frahncky/IoTMotor/THIRD_PARTY_NOTICES.md

# Third-party notices

## Motor sound

The base motor recording used by IoTMotor was obtained from **Pixabay** through
the following sound-effects search page:

https://pixabay.com/pt/sound-effects/search/electric-motor/

Project source file:

```text
dashboard-cloudflare/motor-ligado.mp3
```

Derived application assets:

```text
assets/audio/motor-partida.wav
assets/audio/motor-laco.wav
assets/audio/motor-parada.wav
```

The exact Pixabay item URL, title and contributor were not recorded at the time
of download. If recovered, add them to this file and to
[`docs/audio.md`](docs/audio.md).

License information should be checked against the current Pixabay Content
License:

https://pixabay.com/service/license-summary/

See [`docs/audio.md`](docs/audio.md) for the complete provenance and processing
notes.
