frahncky/IoTMotor/esp32/iotmotor_esp32/iotmotor_esp32_comandos/LEIA-ME-BANCADA.md

# Quadro de comando (ESP32-01)

Sketch `iotmotor_esp32_comandos.ino` para **ESP32 DevKit V1**, ID MQTT `esp32-01`.
Mede com o PZEM-004T, mostra no LCD 20×4 e aciona os contatores CNT 1 a CNT 4 por MQTT.

- Ligações e pinos: [docs/hardware.md](../../../docs/hardware.md#quadro-de-comando-esp32-01)
- Gravar e atualizar: [docs/firmware.md](../../../docs/firmware.md)
- Comandos e telemetria: [docs/mqtt.md](../../../docs/mqtt.md#comandos-do-quadro-de-comando)
- Segurança do ensaio e modo instrumentação: [docs/guia-de-uso.md](../../../docs/guia-de-uso.md#segurança-do-ensaio)
