frahncky/IoTMotor/dashboard-cloudflare/hardware.html

ESP32-01 · PZEM-004T · LCD 20×4

# Pinos e visor LCD

← Voltar ao dashboard

Estado lógico informado pelo firmware; não confirma a posição física dos contatores.

## Contatores

Aguardando dados do ESP32.

CNT 1GPIO19

Sem sinal

CNT 2GPIO18

Sem sinal

CNT 3GPIO23

Sem sinal

CNT 4GPIO27

Sem sinal

PZEM: TX → GPIO16 (RX2), RX → GPIO17 (TX2). LCD I²C: SDA → GPIO21, SCL → GPIO22.

## LCD 20 × 4

Aguardando dados do ESP32.

IoTMotor Modulo 1   
Aguardando dados...

Nenhuma telemetria recente.

## Conexão MQTT

Broker WSS

Prefixo

Dispositivo de comandos

Conectar

Desconectado

Estado do acionamento—Modo de partida—PZEM—Status MQTT recebido—Mensagens novas0

Conecte para acompanhar a telemetria.
