frahncky/IoTMotor/docs/images/celular.png

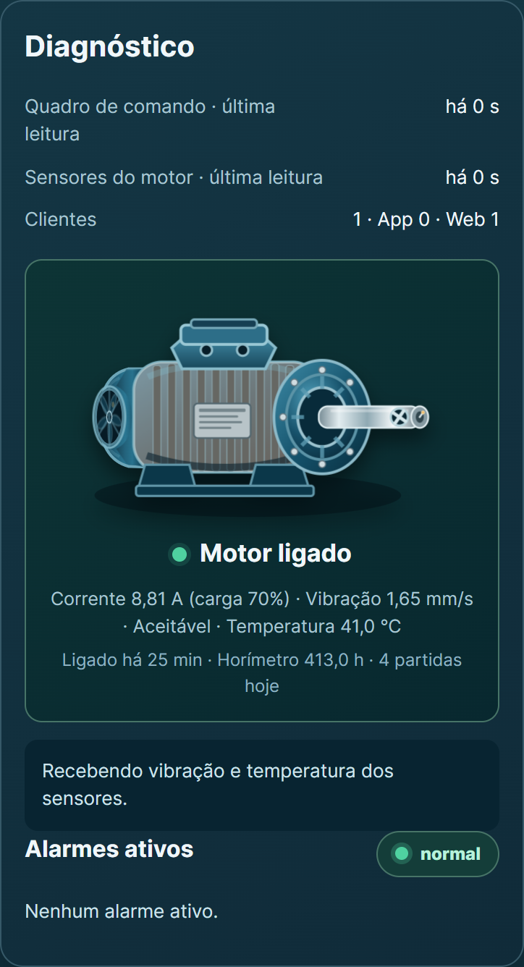
docs/images/celular.png
