frahncky/IoTMotor/docs/images/social-preview.png

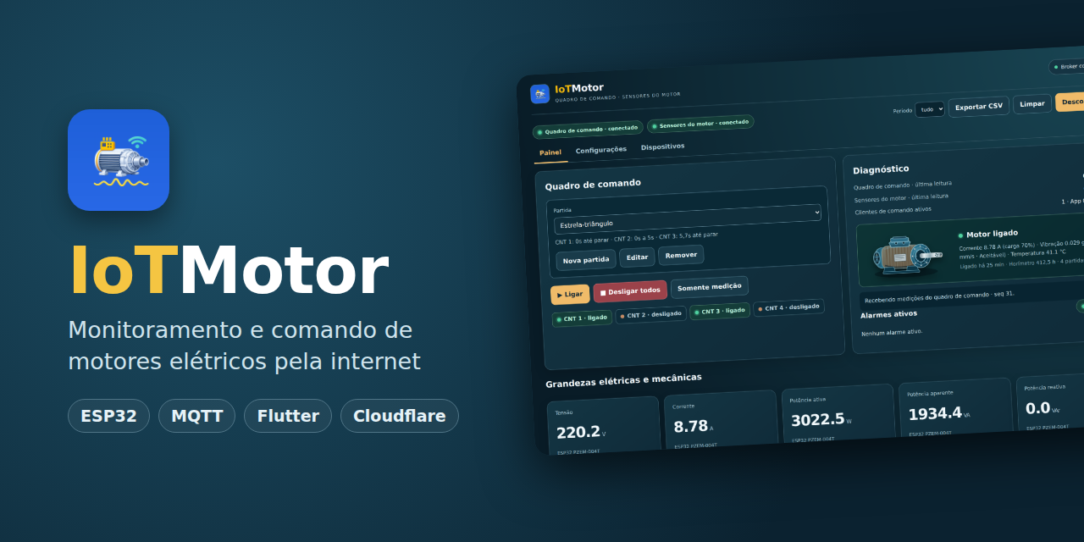
docs/images/social-preview.png
