frahncky/IoTMotor/(list of files, drawings)

Other design files:
hardware/PCBComandos.pdsprj
hardware/PCBSensor.pdsprj
