frahncky/IoTMotor/esp32/iotmotor_esp32/iotmotor_esp32_s3_sensores/iotmotor_esp32_s3_sensores.ino

/* IoTMotor â€” ESP32-S3 (esp32-02): sensores e alarme local, SEM reles.
 * Este sketch pressupoe MPU6050 (SDA GPIO5, SCL GPIO9) e DS18B20
 * (DQ GPIO4, resistor pull-up 4k7 a 3V3), como no projeto de dois modulos.
 * Confirme os pinos da SUA placa S3 antes de gravar. Sensores reais por padrao:
 * campos invalidos sao omitidos; nao inventamos temperatura ou vibracao.
 * Vibracao em velocidade RMS (mm/s), o padrao de maquinas eletricas
 * (ISO 10816-3 / 20816-3): 1000 amostras/s integradas nos 3 eixos (vibracao.h).
 * Bibliotecas: PubSubClient, ArduinoJson 6.x, OneWire, DallasTemperature.
 * Comandos de alarme, Wi-Fi e OTA; nenhum comando de motor.
 */
#include <WiFi.h>
#include <PubSubClient.h>
#include <ArduinoJson.h>
#include <Wire.h>
#include <OneWire.h>
#include <DallasTemperature.h>
#include <math.h>
#include <Preferences.h>
#include <freertos/FreeRTOS.h>
#include <freertos/task.h>
#include <freertos/semphr.h>
#include "mqtt_websocket_client.h"
#define OTA_ARQUIVO "esp32-02.bin"
#define PORTAL_NOME "IoTMotor-esp32-02"
constexpr uint16_t PORTAL_SEGUNDOS = 180;
#include "ota_update.h"
#include "watchdog.h"
#include "wifi_portal.h"
#include "alarm_list.h"
#include "comando_seguro.h"
#include "relogio.h"
#include "historico.h"
#include "vibracao.h"
#include "vibracao_json.h"

// Rede local: crie wifi_local.h na pasta do sketch (fora do Git) a partir de
// wifi_local.exemplo.h para usar outra rede sem publicar a senha no GitHub.
#if __has_include("wifi_local.h")
#include "wifi_local.h"
#endif
#ifndef WIFI_SSID_LOCAL
#define WIFI_SSID_LOCAL "IFMA_IOT"
#define WIFI_PASSWORD_LOCAL ""  // Wi-Fi aberto
#endif
// Redes de wifi_local.h: so semeiam a lista gravada na placa no primeiro boot.
// Depois, a lista e a ordem sao definidas pela aba "Wi-Fi" do painel.
const char* const REDES_INICIAIS[]={
  WIFI_SSID_LOCAL,
#ifdef WIFI_SSID_2
  WIFI_SSID_2,
#endif
#ifdef WIFI_SSID_3
  WIFI_SSID_3,
#endif
#ifdef WIFI_SSID_4
  WIFI_SSID_4,
#endif
};
const char* const SENHAS_INICIAIS[]={
  WIFI_PASSWORD_LOCAL,
#ifdef WIFI_SSID_2
  WIFI_PASSWORD_2,
#endif
#ifdef WIFI_SSID_3
  WIFI_PASSWORD_3,
#endif
#ifdef WIFI_SSID_4
  WIFI_PASSWORD_4,
#endif
};
static const char* MQTT_HOST = "iotmotor.pages.dev";
static const uint16_t MQTT_PORT = 443;  // MQTT sobre WebSocket: a IFMA_IOT bloqueia 1883/8883
static const char* TOPIC_PREFIX = "iotmotor";
static const char* DEVICE_ID = "esp32-02";

static const uint8_t SDA_PIN = 5;
static const uint8_t SCL_PIN = 9;
static const uint8_t DS18B20_PIN = 4;
// Sinalizacao local da placa (mesma pinagem do modulo 2 original).
static const uint8_t BUZZER_PIN = 42;      // Passivo: acionado com tone().
static const uint8_t LED_AZUL_PIN = 16;
static const uint8_t LED_VERDE_PIN = 17;
static const uint8_t LED_VERM_PIN = 18;
static const bool RGB_ANODO_COMUM = false;  // Catodo comum: nivel alto acende.
static const uint32_t BEEP_MS = 400UL;      // Intervalo do alarme intermitente.
static const uint16_t BEEP_HZ_PADRAO = 2000;
static const uint16_t BEEP_HZ_MIN = 500;
static const uint16_t BEEP_HZ_MAX = 5000;
// Limites padrao do alarme; ajustaveis pelo painel e gravados na placa.
// Vibracao em mm/s RMS: 4,5 e o limite de zona D das maquinas pequenas (ISO 10816).
static const float VIBRACAO_LIMITE_PADRAO = 4.5f;
static const float TEMPERATURA_LIMITE_PADRAO = 60.0f;
static const uint8_t MPU_ADDR = 0x68;
static const uint32_t WIFI_RETRY_MS = 6000UL;
static const uint32_t WIFI_RADIO_RESET_MS = 30000UL;
static const uint32_t MQTT_RETRY_MS = 4000UL;
static const uint32_t DIAGNOSTICO_PUBLICAR_MS = 30000UL;
static uint32_t publishMs = 1000UL;
static const uint32_t TEMP_REQUEST_MS = 2000UL;
static const uint32_t TEMP_WAIT_MS = 800UL; // DS18B20 12-bit: ate 750 ms

MqttWebSocketClient net;
PubSubClient mqtt(net);
// Criados apos a procura do sensor: o GPIO4 e o esperado, mas cada placa S3 varia.
OneWire* oneWire=nullptr;
DallasTemperature* ds18b20=nullptr;
uint8_t ds18b20Pin=0;
// Pinos livres candidatos (fora de I2C 5/9, USB 19/20, UART 43/44, strapping
// e dos pinos do LED/buzzer 16/17/18/42).
static const uint8_t DS18B20_CANDIDATOS[]={DS18B20_PIN,1,2,6,7,8,10,11,12,13,14,15,21,38,39,40,41,47,48};
char telemetryTopic[96], statusTopic[96], capabilitiesTopic[96], commandTopic[96], ackTopic[96], wifiTopic[96];
char alarmsTopic[96], quadroTelemetryTopic[96], authTopic[96], alarmLogTopic[96], historyTopic[96], acquisitionTopic[96];
char quadroCommandTopic[96];
uint32_t lastWifiAttempt=0,lastMqttAttempt=0,lastPublish=0,lastHistorico=0,lastDiagnosticsPublish=0;
uint32_t wifiCaiuEm=0;
uint32_t lastTempRequest=0,tempRequestedAt=0,sequence=0,lastMpuRetry=0;
static const uint32_t MPU_RETRY_MS = 5000UL;
// Pedido de reinicio remoto (0 = nenhum); o loop() espera a resposta sair.
uint32_t reiniciarEm=0;
// Sem DS18B20 no boot (mau contato, fio solto), procura de novo sem reiniciar.
static const uint32_t DS18B20_RETRY_MS = 30000UL;
uint32_t lastDs18b20Retry=0;
float temperatureC=NAN;
bool mpuReady=false,tempPending=false,tempReady=false;
// Alarme local: LED RGB e buzzer.
bool alarmeHabilitado=true,estadoCritico=false,buzzerLigado=false;
bool sonsDeEventos=true;  // Bipes curtos de evento, fora da emergencia.
uint16_t buzzerHz=BEEP_HZ_PADRAO;  // Frequencia ajustavel pelo painel e gravada na placa.
uint32_t ultimoBeep=0,inicioDoTeste=0;
bool testeAtivo=false;
bool testeLedAtivo=false;
uint32_t inicioTesteLed=0;
// Ultima janela de 1 s (vibracao.h): velocidade RMS em mm/s.
float mmsAtual=0.0f;
char eixoAtual='x';
bool mmsValida=false;
uint32_t mmsEm=0;  // Quando saiu a ultima velocidade valida.
// Uma janela falha (FIFO cheia durante a procura do DS18B20, por exemplo) nao
// derruba a leitura: sem isso um alarme disparado fecharia e reabriria.
static const uint32_t MMS_VALIDADE_MS = 3000UL;
uint32_t amostrasAtuais=0;
// Estado do motor vem da telemetria do quadro de comando (esp32-01).
bool motorLigado=false;
bool motorGirandoQuadro=false;  // Horimetro do quadro: girando (inclui instrumentacao).
bool saidasDoQuadro=false;      // Algum contator do quadro ligado (ou partida em andamento).
// Desarme: o ultimo Desligar mandado ao quadro por um alarme com desarme.
static const uint32_t DESARME_REPETIR_MS=3000UL;
uint32_t ultimoDesarme=0,sequenciaDesarme=0;
uint32_t ultimaTelemetriaQuadro=0;
static const uint32_t QUADRO_STALE_MS=6000UL;
// Sensores e sinalizacao continuam durante reconexao Wi-Fi, portal e MQTT.
SemaphoreHandle_t sensoresMutex=nullptr;
void aplicarLed(bool azul,bool verde,bool vermelho) {
  digitalWrite(LED_AZUL_PIN, azul==!RGB_ANODO_COMUM?HIGH:LOW);
  digitalWrite(LED_VERDE_PIN, verde==!RGB_ANODO_COMUM?HIGH:LOW);
  digitalWrite(LED_VERM_PIN, vermelho==!RGB_ANODO_COMUM?HIGH:LOW);
}

// Interruptor geral e bipes de evento; os limites ficam na lista de alarmes.
void carregarConfigDoAlarme() {
  Preferences memoria;
  if(!memoria.begin("iot-alarme",true))return;
  alarmeHabilitado=memoria.getBool("ligado",true);
  sonsDeEventos=memoria.getBool("sons",true);
  buzzerHz=constrain((int)memoria.getUShort("buzzer_hz",BEEP_HZ_PADRAO),BEEP_HZ_MIN,BEEP_HZ_MAX);
  memoria.end();
}

bool salvarConfigDoAlarme(bool ligado,bool sons,uint16_t frequencia) {
  Preferences memoria;
  if(!memoria.begin("iot-alarme",false))return false;
  memoria.putBool("ligado",ligado);
  memoria.putBool("sons",sons);
  memoria.putUShort("buzzer_hz",frequencia);
  memoria.end();
  xSemaphoreTake(sensoresMutex,portMAX_DELAY);
  alarmeHabilitado=ligado;sonsDeEventos=sons;buzzerHz=frequencia;
  xSemaphoreGive(sensoresMutex);
  return true;
}

// ---- Bipes curtos fora da emergencia ----
// Avisos de conexao e de comando recebido, e o bipe pedido pelo painel. Sao
// tocados sem travar o laco e nunca atrapalham o alarme, que tem prioridade.
uint8_t beepsRestantes=0;
uint16_t beepFrequencia=BEEP_HZ_PADRAO;
uint32_t beepDuracao=80,beepProximo=0;
bool beepTocando=false;

void pedirBeep(uint8_t vezes,uint16_t frequencia,uint32_t duracaoMs) {
  if(!vezes)return;
  beepsRestantes=vezes;
  beepFrequencia=frequencia;
  beepDuracao=duracaoMs;
  beepProximo=millis();
  beepTocando=false;
}

// ---- Procura do buzzer ----
// Percorre os pinos livres tocando de dois jeitos: tone (buzzer passivo) e
// nivel alto (buzzer ativo). Cada passo e anunciado em command_ack, entao da
// para casar o som ouvido com o pino. Anda no laco principal: chamar
// mqtt.loop() de dentro do tratador de comandos corrompe as mensagens.
static const uint8_t BUZZER_CANDIDATOS[]={42,41,40,39,38,47,48,21,14,13,12,11,10,8,7,6,2,1};
bool probeAtivo=false,probeTocando=false;
uint8_t probeIndice=0,probeModo=0;
uint32_t probePasso=700,probeProximo=0;
String probeSeq;

void beepDeEvento(uint8_t vezes) {
  if(sonsDeEventos)pedirBeep(vezes,buzzerHz,70);
}

// Retorna true enquanto estiver tocando um bipe (o alarme nao mexe no buzzer).
bool atualizarBeeps(uint32_t now) {
  if(!beepsRestantes&&!beepTocando)return false;
  if((int32_t)(now-beepProximo)<0)return true;
  if(beepTocando) {          // Fim do som: silencio do mesmo tamanho.
    noTone(BUZZER_PIN);
    beepTocando=false;
    beepProximo=now+beepDuracao;
    if(!beepsRestantes)return false;
    return true;
  }
  if(!beepsRestantes)return false;
  --beepsRestantes;
  tone(BUZZER_PIN,beepFrequencia);
  beepTocando=true;
  beepProximo=now+beepDuracao;
  return true;
}

// Lista de alarmes retida, para o painel e o app abrirem ja preenchidos.
void publishAlarms() {
  if(!mqtt.connected())return;
  DynamicJsonDocument doc(alarmes::TAMANHO_DOC_ALARMES);
  doc["device_id"]=DEVICE_ID;
  xSemaphoreTake(sensoresMutex,portMAX_DELAY);
  doc["enabled"]=alarmeHabilitado;
  doc["sounds"]=sonsDeEventos;
  doc["buzzer_hz"]=buzzerHz;
  alarmes::descrever(doc);
  xSemaphoreGive(sensoresMutex);
  String texto;
  serializeJson(doc,texto);
  if(texto.length())
    mqtt.publish(alarmsTopic,(const uint8_t*)texto.c_str(),(unsigned int)texto.length(),true);
}

// Ultimos disparos, retidos: o painel abre ja mostrando o que aconteceu.
void publishAlarmLog() {
  if(!mqtt.connected())return;
  // 10 eventos com "trip" passam de 1,5 KB: sobra para nao cortar o fim.
  DynamicJsonDocument doc(3072);
  doc["device_id"]=DEVICE_ID;
  xSemaphoreTake(sensoresMutex,portMAX_DELAY);
  alarmes::descreverEventos(doc);
  alarmes::eventosMudaram=false;
  xSemaphoreGive(sensoresMutex);
  if(doc.overflowed()) {
    Serial.println("[S3/alarmes] registro nao coube no documento; nao publicado");
    return;
  }
  String texto;
  serializeJson(doc,texto);
  if(texto.length())
    mqtt.publish(alarmLogTopic,(const uint8_t*)texto.c_str(),(unsigned int)texto.length(),true);
}

// Historico por hora (historico.h): um topico retido por dia, <prefixo>/<placa>/history/<0..6>.
void publishHistory(uint8_t slot) {
  if(!mqtt.connected())return;
  DynamicJsonDocument doc(4608);
  doc["device_id"]=DEVICE_ID;
  historico::descrever(slot,doc);
  String texto;
  serializeJson(doc,texto);
  char topico[112];
  snprintf(topico,sizeof(topico),"%s/%u",historyTopic,slot);
  if(texto.length()&&!mqtt.publish(topico,(const uint8_t*)texto.c_str(),(unsigned int)texto.length(),true))
    Serial.printf("[S3/historico] falha publicando dia %u (%u bytes)\n",slot,(unsigned int)texto.length());
}

// Uma amostra por segundo para o historico, com as mesmas leituras da telemetria.
void amostrarHistorico() {
  xSemaphoreTake(sensoresMutex,portMAX_DELAY);
  const bool quadroFresco=ultimaTelemetriaQuadro&&(uint32_t)(millis()-ultimaTelemetriaQuadro)<QUADRO_STALE_MS;
  const bool ligado=quadroFresco&&motorGirandoQuadro;
  auto doQuadro=[&](const char* campo){
    return quadroFresco&&alarmes::medidasDoQuadro[campo].is<float>()?alarmes::medidasDoQuadro[campo].as<float>():NAN;
  };
  const float corrente=doQuadro("current"),tensao=doQuadro("voltage");
  const float temperatura=tempReady&&isfinite(temperatureC)?temperatureC:NAN;
  const float vibracao=mpuReady&&mmsValida?mmsAtual:NAN;
  xSemaphoreGive(sensoresMutex);
  historico::amostrar(relogio::agoraUtc(),ligado,corrente,tensao,temperatura,vibracao);
  if(historico::diaParaPublicar>=0){
    publishHistory((uint8_t)historico::diaParaPublicar);
    historico::diaParaPublicar=-1;
  }
}

// Desafio da vez, retido: o painel precisa dele para cifrar um comando.
void publishAuth() {
  if(!mqtt.connected())return;
  StaticJsonDocument<192> doc;
  doc["v"]=1;
  doc["device_id"]=DEVICE_ID;
  comandoseguro::descrever(doc);
  char payload[192];size_t n=serializeJson(doc,payload,sizeof(payload));
  if(n)mqtt.publish(authTopic,(const uint8_t*)payload,(unsigned int)n,true);
}

void publishAck(const char* seq,const char* acao,bool aceito,const char* motivo);

// Avanca a procura do buzzer; true enquanto ela estiver em andamento.
bool atualizarProcuraDoBuzzer(uint32_t now) {
  if(!probeAtivo)return false;
  if((int32_t)(now-probeProximo)<0)return true;
  const uint8_t pino=BUZZER_CANDIDATOS[probeIndice];
  if(probeTocando) {            // Fim do passo: solta o pino e faz uma pausa.
    if(probeModo)digitalWrite(pino,LOW);
    else noTone(pino);
    pinMode(pino,INPUT);
    probeTocando=false;
    probeProximo=now+250;
    if(++probeModo>1) {
      probeModo=0;
      if(++probeIndice>=sizeof(BUZZER_CANDIDATOS)) {
        probeAtivo=false;
        pinMode(BUZZER_PIN,OUTPUT);
        publishAck(probeSeq.c_str(),"buzzer_probe",true,"procura encerrada");
        return false;
      }
    }
    return true;
  }
  // Pula os pinos que ja tem dono nesta placa.
  if(pino==LED_AZUL_PIN||pino==LED_VERDE_PIN||pino==LED_VERM_PIN||pino==ds18b20Pin) {
    probeModo=0;
    if(++probeIndice>=sizeof(BUZZER_CANDIDATOS)) {probeAtivo=false;return false;}
    return true;
  }
  char aviso[64];
  snprintf(aviso,sizeof(aviso),"GPIO%u %s",pino,probeModo?"nivel alto (ativo)":"tone (passivo)");
  publishAck(probeSeq.c_str(),"buzzer_probe",true,aviso);
  Serial.printf("[BUZZER] %s\n",aviso);
  if(probeModo){pinMode(pino,OUTPUT);digitalWrite(pino,HIGH);}
  else tone(pino,buzzerHz);
  probeTocando=true;
  probeProximo=now+probePasso;
  return true;
}

void iniciarTesteLed(uint32_t now) {
  testeLedAtivo=true;
  inicioTesteLed=now;
  noTone(BUZZER_PIN);
  buzzerLigado=false;
  beepsRestantes=0;
  beepTocando=false;
}

bool atualizarTesteLed(uint32_t now) {
  if(!testeLedAtivo)return false;
  const uint32_t decorrido=(uint32_t)(now-inicioTesteLed);
  if(decorrido<1000UL) aplicarLed(true,false,false);        // azul
  else if(decorrido<2000UL) aplicarLed(false,true,false);    // verde
  else if(decorrido<3000UL) aplicarLed(false,false,true);    // vermelho
  else {
    testeLedAtivo=false;
    return false;
  }
  return true;
}

// Maquina de estados do LED:
// azul piscando = conectando; azul fixo = conectado/motor desligado;
// verde fixo = motor ligado normal; vermelho piscando = motor ligado anormal;
// vermelho fixo = falha de sensor com motor desligado.
void atualizarSinalizacao(uint32_t now) {
  if(atualizarProcuraDoBuzzer(now))return;  // Procura do buzzer em andamento.
  if(atualizarTesteLed(now))return;

  // Quem decide os alarmes e a lista configurada na placa. Avaliados tambem
  // sem rede: temperatura e vibracao sao medidas aqui mesmo.
  const bool algumDisparou=alarmes::avaliar(now,mpuReady,tempReady,mmsValida?mmsAtual:NAN,
                                            temperatureC,relogio::agoraUtc());
  const bool falhaSensor=!mpuReady || !tempReady;
  estadoCritico=alarmeHabilitado&&(algumDisparou||falhaSensor);

  if(testeAtivo&&(uint32_t)(now-inicioDoTeste)<1500UL)return;
  testeAtivo=false;

  const bool conectado=WiFi.status()==WL_CONNECTED && mqtt.connected();
  // Com rede, se a telemetria do quadro sumir, nao inventa que o motor segue
  // ligado. Sem rede a falha e desta placa, nao do motor: vale o ultimo estado
  // recebido, para o alarme local nao ficar mudo com o motor girando.
  const bool quadroRecente=ultimaTelemetriaQuadro &&
                           (uint32_t)(now-ultimaTelemetriaQuadro)<QUADRO_STALE_MS;
  const bool motorAtivo=conectado?quadroRecente&&motorLigado:motorLigado;

  if(!conectado&&!(motorAtivo&&estadoCritico)) {  // Procurando rede: azul piscando.
    const bool aceso=((now/500UL)&1U)==0U;
    aplicarLed(aceso,false,false);
    if(buzzerLigado){noTone(BUZZER_PIN);buzzerLigado=false;}
    atualizarBeeps(now);  // Termina o bipe em curso; zerar deixaria o tom preso.
    return;
  }

  if(!motorAtivo) {
    if(estadoCritico) aplicarLed(false,false,true);  // falha parada: vermelho fixo
    else aplicarLed(true,false,false);               // conectado/parado: azul fixo
    if(buzzerLigado){noTone(BUZZER_PIN);buzzerLigado=false;}
    // Motor parado nao apita alarme, mas o bipe pedido pelo painel toca.
    atualizarBeeps(now);
    return;
  }

  if(!estadoCritico) {
    aplicarLed(false,true,false);                    // motor ligado normal: verde
    if(buzzerLigado){noTone(BUZZER_PIN);buzzerLigado=false;}
    atualizarBeeps(now);
    return;
  }

  // Motor ligado e anormal: vermelho piscando + buzzer intermitente.
  const bool vermelho=((now/500UL)&1U)==0U;
  aplicarLed(false,false,vermelho);
  beepsRestantes=0;beepTocando=false;
  if((uint32_t)(now-ultimoBeep)>=BEEP_MS) {
    ultimoBeep=now;
    buzzerLigado=!buzzerLigado;
    if(buzzerLigado)tone(BUZZER_PIN,buzzerHz);
    else noTone(BUZZER_PIN);
  }
}

void testarSinalizacao(uint32_t now,uint16_t frequencia) {
  inicioDoTeste=now;testeAtivo=true;
  ultimoBeep=now;
  aplicarLed(true,true,true);
  tone(BUZZER_PIN,frequencia);
  buzzerLigado=true;
}

// Procura um DS18B20 nos pinos candidatos; so aceita ROM lida com CRC valido.
// Retorna true se encontrou. avisarFalha=false evita repetir o aviso a cada nova tentativa.
bool procurarDs18b20(bool avisarFalha) {
  for (uint8_t pino : DS18B20_CANDIDATOS) {
    OneWire barramento(pino);
    DallasTemperature sensor(&barramento);
    sensor.begin();
    DeviceAddress rom;
    // getAddress ja rejeita ROM com CRC invalido (validAddress).
    if (sensor.getDeviceCount() < 1 || !sensor.getAddress(rom,0)) continue;
    ds18b20Pin=pino;
    oneWire=new OneWire(pino);
    ds18b20=new DallasTemperature(oneWire);
    ds18b20->begin();
    ds18b20->setWaitForConversion(false);
    Serial.printf("[S3/DS18B20] encontrado no GPIO%u\n",pino);
    if (pino!=DS18B20_PIN) Serial.printf("[S3/DS18B20] atencao: esperado no GPIO%u\n",DS18B20_PIN);
    return true;
  }
  if (!avisarFalha) return false;
  Serial.printf("[S3/DS18B20] nenhum sensor no GPIO%u nem nos demais pinos livres;"
                " confira DQ, GND, 3V3 e o resistor de 4k7 entre DQ e 3V3;"
                " nova procura a cada %lu s\n",DS18B20_PIN,(unsigned long)(DS18B20_RETRY_MS/1000UL));
  return false;
}

void publishStatus(const char* msg) {
  Serial.printf("[S3/status] %s\n",msg);
  if (mqtt.connected()) mqtt.publish(statusTopic,msg,true);
}

bool mpuWrite(uint8_t reg,uint8_t value) {
  Wire.beginTransmission(MPU_ADDR);
  Wire.write(reg); Wire.write(value);
  return Wire.endTransmission()==0;
}

bool initMpu(bool avisarFalha) {
  // WHO_AM_I (0x75) so confirma presenca: clones MPU6500/9250 respondem 0x70/0x71/0x73
  // e funcionam com os mesmos registradores, entao qualquer resposta e aceita.
  Wire.beginTransmission(MPU_ADDR);
  Wire.write((uint8_t)0x75);
  bool ok=Wire.endTransmission(false)==0 && Wire.requestFrom(MPU_ADDR,(uint8_t)1,(bool)true)==1;
  const uint8_t id=ok?Wire.read():0;
  ok=ok&&mpuWrite(0x6B,0x00);  // wake up
  delay(ok?50:0);              // Acordando: o oscilador precisa estabilizar.
  ok=ok&&vibracao::iniciar(id);
  if(ok) Serial.printf("[S3/MPU6050] iniciado nos GPIO5/9, WHO_AM_I=0x%02X, 1000 amostras/s\n",id);
  else if(avisarFalha) Serial.println("[S3/MPU6050] indisponivel; confira I2C e alimentacao (nova tentativa a cada 5 s)");
  return ok;
}

void sampleMpu() {
  if(!mpuReady)return;
  if(!vibracao::ler()) {
    mpuReady=false;
    Serial.println("[S3/MPU6050] leitura falhou; tentara reiniciar");
  }
}

void pollTemperature(uint32_t now) {
  if(!ds18b20)return;
  if(tempPending && (uint32_t)(now-tempRequestedAt)>=TEMP_WAIT_MS) {
    float reading=ds18b20->getTempCByIndex(0);
    tempReady=isfinite(reading) && reading>-55.0f && reading<125.0f &&
              reading!=85.0f && reading!=DEVICE_DISCONNECTED_C;
    temperatureC=tempReady?reading:NAN;
    static int8_t ultimoEstado=-1;  // Avisa so na mudanca: evita repetir a cada 2 s.
    if(tempReady!=(ultimoEstado==1)||ultimoEstado<0) {
      if(tempReady)Serial.printf("[S3/DS18B20] %.2f C\n",temperatureC);
      else Serial.println("[S3/DS18B20] sensor ausente/leitura invalida");
      ultimoEstado=tempReady?1:0;
    }
    tempPending=false;
  }
  if(!tempPending && (lastTempRequest==0 || (uint32_t)(now-lastTempRequest)>=TEMP_REQUEST_MS)) {
    lastTempRequest=now;
    ds18b20->requestTemperatures(); // setWaitForConversion(false) na deteccao
    tempRequestedAt=now;
    tempPending=true;
  }
}

// Executada independentemente das operacoes de rede potencialmente bloqueantes.
void tarefaSensores(void*) {
  uint32_t ultimaJanela=millis();
  for(;;) {
    const uint32_t now=millis();
    xSemaphoreTake(sensoresMutex,portMAX_DELAY);
    sampleMpu();  // Esvazia a FIFO do MPU (1000 amostras/s).
    if(!mpuReady&&(uint32_t)(now-lastMpuRetry)>=MPU_RETRY_MS) {
      lastMpuRetry=now;
      mpuReady=initMpu(false);
    }
    // Nao varre os pinos enquanto a procura do buzzer pode estar acionando algum deles.
    if(!ds18b20&&!probeAtivo&&(uint32_t)(now-lastDs18b20Retry)>=DS18B20_RETRY_MS) {
      lastDs18b20Retry=now;
      procurarDs18b20(false);
    }
    pollTemperature(now);
    if((uint32_t)(now-ultimaJanela)>=1000UL) {
      ultimaJanela=now;
      vibracao::fecharJanela(mpuReady);
      amostrasAtuais=vibracao::amostras;
      if(vibracao::velocidadeValida) {
        mmsAtual=vibracao::mmS;
        eixoAtual=vibracao::eixo;
        mmsEm=now?now:1;
      }
      mmsValida=mpuReady&&mmsEm&&(uint32_t)(now-mmsEm)<MMS_VALIDADE_MS;
      static uint32_t perdasAvisadas=0;
      if(vibracao::perdas!=perdasAvisadas) {
        Serial.printf("[S3/MPU6050] FIFO cheia %lu vez(es): amostras perdidas\n",(unsigned long)vibracao::perdas);
        perdasAvisadas=vibracao::perdas;
      }
    }
    atualizarSinalizacao(now);
    xSemaphoreGive(sensoresMutex);
    vTaskDelay(pdMS_TO_TICKS(2));
  }
}

void publishCapabilities() {
  StaticJsonDocument<384> doc;
  doc["device_id"]=DEVICE_ID;
  doc["firmware_version"]="s3-sensors-1.23-mqtt-cloudflare";
  doc["demo"]=false;
  doc["accepts_direct_command"]=false;
  doc["accepts_command_request"]=false;
  JsonArray fields=doc.createNestedArray("fields");
  fields.add("vibration_mms");fields.add("temperature");fields.add("vib");
  char payload[384];size_t n=serializeJson(doc,payload,sizeof(payload));
  if(n)mqtt.publish(capabilitiesTopic,(const uint8_t*)payload,(unsigned int)n,true);
}

void publishTelemetry() {
  if(!mqtt.connected())return;
  // Estaticos: com o diagnostico da vibracao, ~5 KB nao cabem na pilha do loop.
  static StaticJsonDocument<3072> doc;
  static char payload[2048];
  doc.clear();
  xSemaphoreTake(sensoresMutex,portMAX_DELAY);
  doc["device_id"]=DEVICE_ID;
  doc["seq"]=++sequence;
  doc["demo"]=false;
  doc["data_source"]="mpu6050_ds18b20";
  doc["mpu_ok"]=mpuReady;
  doc["temperature_ok"]=tempReady;
  doc["sample_count"]=amostrasAtuais;
  doc["secure"]=comandoseguro::ligado;
  // Hora da medicao, em segundos UTC. Ausente enquanto o NTP nao responde.
  if(const uint32_t carimbo=relogio::agoraUtc())doc["ts"]=carimbo;
  doc["alarm_enabled"]=alarmeHabilitado;
  doc["event_sounds"]=sonsDeEventos;
  doc["buzzer_hz"]=buzzerHz;
  doc["alarm_active"]=estadoCritico;
  doc["motor_on"]=motorLigado;
  doc["command_telemetry_fresh"]=ultimaTelemetriaQuadro &&
      (uint32_t)(millis()-ultimaTelemetriaQuadro)<QUADRO_STALE_MS;
  if(mpuReady && mmsValida) {
    doc["vibration_mms"]=mmsAtual;  // Velocidade RMS, mm/s, 10 Hz a ~180 Hz, pior eixo
    doc["vibration_axis"]=String(eixoAtual);  // x, y ou z (String: copiado)
  }
  // Da ultima janela de 1 s, so se ela valeu (o mm/s acima tolera 3 s).
  if(mpuReady && vibracao::velocidadeValida)vibracaojson::descrever(doc.createNestedObject("vib"));
  if(tempReady && isfinite(temperatureC))doc["temperature"]=temperatureC;
  JsonArray disparados=doc.createNestedArray("alarms_firing");
  for(uint8_t i=0;i<alarmes::total;i++)
    if(alarmes::lista[i].disparado)disparados.add(alarmes::lista[i].id);
  xSemaphoreGive(sensoresMutex);
  size_t n=serializeJson(doc,payload,sizeof(payload));
  if(doc.overflowed())Serial.println("[S3/MQTT] telemetria nao coube no documento JSON");
  if(!n||!mqtt.publish(telemetryTopic,(const uint8_t*)payload,(unsigned int)n,false))
    Serial.printf("[S3/MQTT] falha publicando, state=%d bytes=%u\n",mqtt.state(),(unsigned int)n);
  else if(sequence%10==1)Serial.printf("[S3/MQTT] telemetria seq=%lu, amostras=%lu, temp_ok=%d\n",(unsigned long)sequence,doc["sample_count"].as<unsigned long>(),doc["temperature_ok"].as<bool>());
}

// Lista de redes gravada na placa, sem senhas, com a chave publica para o
// painel cifrar senhas novas. Retida para a aba "Wi-Fi" abrir ja preenchida.
void publishNetworks() {
  if(!mqtt.connected())return;
  StaticJsonDocument<1536> doc;
  doc["device_id"]=DEVICE_ID;
  wifistore::descrever(doc);
  char payload[1536];size_t n=serializeJson(doc,payload,sizeof(payload));
  if(n)mqtt.publish(wifiTopic,(const uint8_t*)payload,(unsigned int)n,true);
}

void publishAck(const char* seq,const char* acao,bool aceito,const char* motivo) {
  StaticJsonDocument<256> resposta;
  resposta["device_id"]=DEVICE_ID;resposta["seq"]=seq;resposta["action"]=acao;
  resposta["accepted"]=aceito;resposta["reason"]=motivo;
  char saida[256];size_t n=serializeJson(resposta,saida,sizeof(saida));
  if(n)mqtt.publish(ackTopic,(const uint8_t*)saida,(unsigned int)n,false);
}

// Comandos aceitos: alarme, lista de redes Wi-Fi, portal e atualizacao.
void onCommand(char* topic, uint8_t* payload, unsigned int length) {
  if(!topic || !length)return;
  if(!strcmp(topic,acquisitionTopic)) {
    StaticJsonDocument<384> cfg;
    if(length<=384 && !deserializeJson(cfg,(const char*)payload,length)) {
      const uint32_t recebido=cfg["publish_ms"] | 1000UL;
      if(recebido>=1000UL && recebido<=60000UL) {
        publishMs=recebido;
        Serial.printf("[S3/CONFIG] telemetria a cada %lu ms\n",(unsigned long)publishMs);
      }
    }
    return;
  }
  if(!strcmp(topic,quadroTelemetryTopic)) {  // Medidas eletricas e estado do motor.
    // A telemetria do quadro passa de 900 bytes com horimetro e partidas: le
    // no heap, uma vez so, e repassa o documento aos alarmes.
    if(length<=1800) {
      DynamicJsonDocument quadro(3072);
      if(!deserializeJson(quadro,(const char*)payload,length) &&
         !strcmp(quadro["device_id"] | "","esp32-01")) {
        // Estado do motor: use a informacao da partida ativa publicada pelo esp32-01.
        // Nao trate "qualquer rele ligado" como motor ligado, pois ha estados/manobras
        // em que um rele pode permanecer energizado sem o motor estar em operacao.
        bool ligado=false;
        const char* modo=quadro["mode"] | "";
        const char* perfil=quadro["profile"] | "";
        const char* fase=quadro["start_phase"] | "";
        if(!strcmp(modo,"profile_bench") || perfil[0]) ligado=true;
        // Compatibilidade: algumas versoes antigas nao publicam profile.
        else if(fase[0] && strcmp(fase,"Parado / comando manual") &&
                     strcmp(fase,"parado") && strcmp(fase,"stopped")) ligado=true;
        // Para o historico vale a mesma regra do horimetro do quadro (inclui o
        // modo instrumentacao, em que o motor gira sem partida ativa).
        const bool girando=quadro["motor_running"].is<bool>()?quadro["motor_running"].as<bool>():ligado;
        bool saidas=perfil[0]!='\0';
        for(JsonVariantConst r:quadro["relays"].as<JsonArrayConst>())saidas=saidas||r.as<bool>();
        xSemaphoreTake(sensoresMutex,portMAX_DELAY);
        // Em modo instrumentacao o motor gira sem partida pelo quadro (comando
        // eletrico externo): girando vem da corrente medida. Os alarmes tocam
        // do mesmo jeito.
        motorLigado=ligado||girando;
        saidasDoQuadro=saidas;
        motorGirandoQuadro=girando;
        ultimaTelemetriaQuadro=millis();
        alarmes::receberMedidasDoQuadro(quadro.as<JsonVariantConst>(),ultimaTelemetriaQuadro);
        xSemaphoreGive(sensoresMutex);
      }
    }
    return;
  }
  if(strcmp(topic,commandTopic) || length>1400)return;
  StaticJsonDocument<768> doc;
  if(deserializeJson(doc,payload,length) || doc["v"].as<int>()!=1 ||
     strcmp(doc["device_id"] | "",DEVICE_ID))return;

  // Com senha configurada, so passa comando cifrado e com o desafio da vez.
  if(comandoseguro::ligado) {
    static char aberto[comandoseguro::MAX_ABERTO];
    const char* motivoSelo="";
    if(!(doc["sealed"] | "")[0]) {
      publishAck(doc["seq"] | "",doc["action"] | "sealed",false,
                 "comando sem selo: configure a senha de comando");
      return;
    }
    if(!comandoseguro::abrir(doc["sealed"] | "",DEVICE_ID,aberto,sizeof(aberto),motivoSelo)) {
      publishAck(doc["seq"] | "","sealed",false,motivoSelo);
      return;
    }
    doc.clear();
    if(deserializeJson(doc,aberto) || doc["v"].as<int>()!=1 ||
       strcmp(doc["device_id"] | "",DEVICE_ID))return;
    if(!comandoseguro::confereDesafio(doc["ch"] | "")) {
      publishAck(doc["seq"] | "",doc["action"] | "sealed",false,"desafio vencido: envie de novo");
      return;
    }
    comandoseguro::usar();  // Comando repetido do ar nao vale mais.
    publishAuth();
  }

  const char* acao=doc["action"] | "";
  const char* seq=doc["seq"] | "";
  // O teste de LED deve ser totalmente silencioso.
  if(strcmp(acao,"led_test")) beepDeEvento(1);  // Confirma na bancada os demais comandos.
  // Lista de redes: a senha chega cifrada para a chave desta placa.
  const char* motivoWifi="";
  const wifistore::Resultado resultado=wifistore::tratarComando(acao,doc.as<JsonVariantConst>(),motivoWifi);
  if(resultado!=wifistore::Resultado::NaoEWifi) {
    publishAck(seq,acao,resultado==wifistore::Resultado::Aceito,motivoWifi);
    publishNetworks();
    return;
  }
  // Portal de cadastro na propria placa (ultimo recurso).
  if(!strcmp(acao,"wifi_portal")) {
    publishAck(seq,acao,true,"rede da placa aberta por 180 s");
    delay(200);
    abrirPortalDeRede(PORTAL_SEGUNDOS);
    ESP.restart();
    return;
  }
  if(!strcmp(acao,"buzzer_probe")) {  // Procura o buzzer; anda no laco principal.
    probeSeq=seq;
    probePasso=constrain((long)(doc["ms"] | 700),200,2000);
    probeIndice=0;probeModo=0;probeTocando=false;probeProximo=millis();probeAtivo=true;
    publishAck(seq,acao,true,"procurando o buzzer: ouca a placa");
    return;
  }
  if(!strcmp(acao,"buzzer_beep")) {  // Bipe pedido pelo painel ou pelo app.
    const uint16_t frequencia=constrain((int)(doc["freq"] | buzzerHz),BEEP_HZ_MIN,BEEP_HZ_MAX);
    const uint32_t duracao=constrain((long)(doc["ms"] | 120),20,2000);
    const uint8_t vezes=constrain((int)(doc["count"] | 1),1,5);
    pedirBeep(vezes,frequencia,duracao);
    publishAck(seq,acao,true,"bipe acionado");
    return;
  }
  if(!strcmp(acao,"led_test")) {  // Mostra azul, verde e vermelho sem buzzer.
    xSemaphoreTake(sensoresMutex,portMAX_DELAY);
    iniciarTesteLed(millis());
    xSemaphoreGive(sensoresMutex);
    publishAck(seq,acao,true,"LED: azul, verde e vermelho");
    return;
  }
  if(!strcmp(acao,"alarm_test")) {  // Acende tudo e apita por 1,5 s.
    const uint16_t frequencia=constrain((int)(doc["freq"] | buzzerHz),BEEP_HZ_MIN,BEEP_HZ_MAX);
    xSemaphoreTake(sensoresMutex,portMAX_DELAY);
    testarSinalizacao(millis(),frequencia);
    xSemaphoreGive(sensoresMutex);
    publishAck(seq,acao,true,"LED e buzzer acionados por 1,5 s");
    return;
  }
  if(!strcmp(acao,"alarm_set")) {  // Interruptor geral, bipes e tom do buzzer.
    if(!doc["enabled"].is<bool>()) {
      publishAck(seq,acao,false,"campo enabled ausente");
      return;
    }
    const int freqPedido=doc["buzzer_hz"] | (int)buzzerHz;
    if(freqPedido<BEEP_HZ_MIN || freqPedido>BEEP_HZ_MAX) {
      publishAck(seq,acao,false,"buzzer_hz deve ficar entre 500 e 5000 Hz");
      return;
    }
    const bool ok=salvarConfigDoAlarme(doc["enabled"].as<bool>(),
                                       doc["sounds"] | sonsDeEventos,
                                       (uint16_t)freqPedido);
    publishAck(seq,acao,ok,ok?"alarme e buzzer configurados":"falha ao gravar");
    if(ok)publishAlarms();
    return;
  }
  if(!strcmp(acao,"alarm_list")) {  // O painel pedindo a lista atual.
    publishAck(seq,acao,true,"lista publicada");
    publishAlarms();
    publishAlarmLog();
    return;
  }
  if(!strcmp(acao,"alarm_save")) {  // Cria ou edita um alarme da lista.
    const char* motivo="";
    xSemaphoreTake(sensoresMutex,portMAX_DELAY);
    const bool ok=alarmes::salvar(doc["alarm"],motivo);
    xSemaphoreGive(sensoresMutex);
    publishAck(seq,acao,ok,motivo);
    if(ok)publishAlarms();
    return;
  }
  if(!strcmp(acao,"alarm_remove")) {  // Tira um alarme da lista.
    const char* motivo="";
    xSemaphoreTake(sensoresMutex,portMAX_DELAY);
    const bool ok=alarmes::remover(doc["id"] | "",motivo);
    xSemaphoreGive(sensoresMutex);
    publishAck(seq,acao,ok,motivo);
    if(ok)publishAlarms();
    return;
  }
  // Reinicio remoto: mesmo efeito do botao de reset. Esta placa so mede,
  // entao reiniciar nao mexe no motor; volta em poucos segundos.
  // O loop() reinicia logo depois, para a resposta sair antes.
  if(!strcmp(acao,"restart")) {
    publishAck(seq,acao,true,"reiniciando");
    reiniciarEm=millis()|1U;
    return;
  }
  if(strcmp(acao,"update"))return;
  StaticJsonDocument<256> resposta;
  resposta["device_id"]=DEVICE_ID;resposta["seq"]=seq;resposta["action"]="update";
  resposta["accepted"]=true;resposta["reason"]="baixando firmware";
  char saida[256];size_t n=serializeJson(resposta,saida,sizeof(saida));
  if(n)mqtt.publish(ackTopic,(const uint8_t*)saida,(unsigned int)n,false);
  String motivo;
  atualizarPelaInternet(OTA_ARQUIVO,motivo);  // Sucesso reinicia a placa.
  resposta["accepted"]=false;resposta["reason"]=motivo;
  n=serializeJson(resposta,saida,sizeof(saida));
  if(n)mqtt.publish(ackTopic,(const uint8_t*)saida,(unsigned int)n,false);
}

// Desarme automatico: um alarme com desarme disparado, com o quadro acionando
// o motor, manda o quadro desligar. Repete a cada 3 s enquanto o alarme
// seguir disparado, entao religar com o alarme ativo cai de novo. Precisa do
// broker (as placas so se falam por ele). O quadro aceita Desligar sem selo
// (v15 em diante), entao vale tambem com senha de comando.
void verificarDesarme(uint32_t now) {
  if(!mqtt.connected())return;
  if(ultimoDesarme&&(uint32_t)(now-ultimoDesarme)<DESARME_REPETIR_MS)return;
  char id[alarmes::MAX_ID_ALARME+1]="",campo[alarmes::MAX_CAMPO+1]="";
  xSemaphoreTake(sensoresMutex,portMAX_DELAY);
  const bool quadroFresco=ultimaTelemetriaQuadro&&(uint32_t)(now-ultimaTelemetriaQuadro)<QUADRO_STALE_MS;
  if(alarmeHabilitado&&quadroFresco&&saidasDoQuadro) {
    for(uint8_t i=0;i<alarmes::total;i++) {
      const alarmes::Alarme& a=alarmes::lista[i];
      if(!a.desarma||!a.disparado)continue;
      strncpy(id,a.id,sizeof(id)-1);
      strncpy(campo,a.campo,sizeof(campo)-1);
      alarmes::anotarDesarme(a.id);
      break;
    }
  }
  xSemaphoreGive(sensoresMutex);
  if(!id[0])return;
  ultimoDesarme=now|1U;
  StaticJsonDocument<256> doc;
  char seq[24];
  snprintf(seq,sizeof(seq),"%lu%03lu",(unsigned long)(now|1U),(unsigned long)(++sequenciaDesarme%1000));
  doc["v"]=1;doc["device_id"]="esp32-01";doc["seq"]=seq;doc["action"]="stop";
  doc["reason"]="alarm";doc["alarm"]=id;doc["field"]=campo;
  char payload[256];size_t n=serializeJson(doc,payload,sizeof(payload));
  if(n&&mqtt.publish(quadroCommandTopic,(const uint8_t*)payload,(unsigned int)n,false))
    Serial.printf("[S3/desarme] alarme %s (%s): Desligar enviado ao quadro\n",id,campo);
}

void recuperarWifiS3() {
  // Limpa qualquer sessao MQTT/WebSocket antiga antes de reiniciar o radio.
  mqtt.disconnect();
  net.stop();
  WiFi.disconnect(false,false);
  delay(50);
  WiFi.mode(WIFI_OFF);
  delay(150);
  WiFi.mode(WIFI_STA);
  WiFi.setAutoReconnect(true);
  WiFi.setSleep(false);
  delay(100);
  lastMqttAttempt=0;
  lastWifiAttempt=0;
  Serial.println("[S3/Wi-Fi] radio reiniciado para recuperar conexao");
}

bool conectarWifiS3(uint32_t esperaPadraoMs) {
  return wifistore::conectarEmOrdem(esperaPadraoMs);
}

void setup() {
  Serial.begin(115200);
  Wire.begin(SDA_PIN,SCL_PIN);
  Wire.setClock(400000);  // 1000 amostras/s do MPU pedem o I2C rapido.
  pinMode(LED_AZUL_PIN,OUTPUT);pinMode(LED_VERDE_PIN,OUTPUT);pinMode(LED_VERM_PIN,OUTPUT);
  pinMode(BUZZER_PIN,OUTPUT);noTone(BUZZER_PIN);
  comandoseguro::iniciar(DEVICE_ID);
  carregarConfigDoAlarme();
  alarmes::carregar(VIBRACAO_LIMITE_PADRAO,TEMPERATURA_LIMITE_PADRAO);
  historico::carregar();
  aplicarLed(true,false,false);  // Azul durante a inicializacao/conexao.
  mpuReady=initMpu(true);
  lastMpuRetry=millis();
  procurarDs18b20(true);
  lastDs18b20Retry=millis();
  sensoresMutex=xSemaphoreCreateMutex();
  if(!sensoresMutex||xTaskCreate(tarefaSensores,"sensores",4096,nullptr,1,nullptr)!=pdPASS) {
    Serial.println("[S3/alarme] falha ao iniciar tarefa de sensores");
    for(;;)delay(1000);
  }
  snprintf(telemetryTopic,sizeof(telemetryTopic),"%s/%s/telemetry",TOPIC_PREFIX,DEVICE_ID);
  snprintf(statusTopic,sizeof(statusTopic),"%s/%s/status",TOPIC_PREFIX,DEVICE_ID);
  snprintf(capabilitiesTopic,sizeof(capabilitiesTopic),"%s/%s/capabilities",TOPIC_PREFIX,DEVICE_ID);
  snprintf(commandTopic,sizeof(commandTopic),"%s/%s/command",TOPIC_PREFIX,DEVICE_ID);
  snprintf(ackTopic,sizeof(ackTopic),"%s/%s/command_ack",TOPIC_PREFIX,DEVICE_ID);
  mqtt.setServer(MQTT_HOST,MQTT_PORT);
  snprintf(wifiTopic,sizeof(wifiTopic),"%s/%s/wifi",TOPIC_PREFIX,DEVICE_ID);
  snprintf(alarmsTopic,sizeof(alarmsTopic),"%s/%s/alarms",TOPIC_PREFIX,DEVICE_ID);
  snprintf(authTopic,sizeof(authTopic),"%s/%s/auth",TOPIC_PREFIX,DEVICE_ID);
  snprintf(alarmLogTopic,sizeof(alarmLogTopic),"%s/%s/alarm_log",TOPIC_PREFIX,DEVICE_ID);
  snprintf(historyTopic,sizeof(historyTopic),"%s/%s/history",TOPIC_PREFIX,DEVICE_ID);
  // Alarmes de tensao e corrente leem a telemetria do quadro de comando.
  snprintf(quadroTelemetryTopic,sizeof(quadroTelemetryTopic),"%s/esp32-01/telemetry",TOPIC_PREFIX);
  snprintf(acquisitionTopic,sizeof(acquisitionTopic),"%s/system/acquisition",TOPIC_PREFIX);
  snprintf(quadroCommandTopic,sizeof(quadroCommandTopic),"%s/esp32-01/command",TOPIC_PREFIX);
  mqtt.setBufferSize(2048);  // Cabe um dia inteiro do historico.
  mqtt.setCallback(onCommand);
  WiFi.mode(WIFI_STA);
  wifistore::iniciarDiagnostico();
  WiFi.setAutoReconnect(true);
  WiFi.setSleep(false);  // Mantem o radio acordado: melhora estabilidade perto do motor.
  wifistore::carregar(REDES_INICIAIS,SENHAS_INICIAIS,sizeof(REDES_INICIAIS)/sizeof(REDES_INICIAIS[0]));
  wifistore::prepararChaves();
  wifistore::carregarRedePropria(PORTAL_NOME);
  Serial.printf("[S3/Wi-Fi] %u rede(s) na lista da placa\n",wifistore::total);
  // No boot, nunca bloqueia a placa no portal automatico. Uma rede pode
  // demorar alguns segundos para ficar disponivel depois de uma queda geral.
  // Se a primeira tentativa falhar, o loop continua tentando as redes salvas.
  // O portal permanece disponivel somente quando solicitado pelo painel.
  if(!conectarWifiS3(3500))
    Serial.println("[S3/Wi-Fi] nenhuma rede entrou no boot; continuara tentando");
  Serial.printf("[S3/boot] %s broker=%s:%u\n",DEVICE_ID,MQTT_HOST,MQTT_PORT);
  watchdog::iniciar();  // Depois das esperas longas do boot (Wi-Fi).
}

void loop() {
  uint32_t now=millis();
  if(reiniciarEm && (uint32_t)(now-reiniciarEm)>=300UL) {
    Serial.println("[S3] reiniciando a pedido do painel");
    ESP.restart();
  }
  // O historico fica na placa justamente para nao depender da rede: amostra
  // com ou sem broker (a hora do NTP segue valendo depois de sincronizada).
  // Os dias fechados sem conexao saem todos ao reconectar.
  if(lastHistorico==0 || (uint32_t)(now-lastHistorico)>=1000UL) {
    lastHistorico=now;
    amostrarHistorico();
  }

  if(WiFi.status()!=WL_CONNECTED) {
    if(!wifiCaiuEm) {
      wifiCaiuEm=now;
      mqtt.disconnect();
      net.stop();  // descarta WebSocket antigo imediatamente
      Serial.printf("[S3/Wi-Fi] conexao perdida, status=%d\n",WiFi.status());
    }
    if((uint32_t)(now-wifiCaiuEm)>=WIFI_RADIO_RESET_MS) {
      recuperarWifiS3();
      wifiCaiuEm=millis();
      now=wifiCaiuEm;
    }
    if(lastWifiAttempt==0 || (uint32_t)(now-lastWifiAttempt)>=WIFI_RETRY_MS) {
      lastWifiAttempt=now;
      Serial.printf("[S3/Wi-Fi] reconectando, status=%d\n",WiFi.status());
      conectarWifiS3(3500);  // Ultima valida; visiveis; depois nao vistas.
    }
    delay(2);return;
  }
  // Hora pelo NTP assim que ha Wi-Fi, mesmo com o broker fora: sem ela o
  // historico descarta as amostras.
  relogio::manter(now);
  if(wifiCaiuEm) {
    Serial.printf("[S3/Wi-Fi] recuperado em %lu ms, rede=%s, RSSI=%d dBm\n",
                  (unsigned long)(now-wifiCaiuEm),WiFi.SSID().c_str(),WiFi.RSSI());
    wifiCaiuEm=0;
    lastMqttAttempt=0;
  }
  if(!mqtt.connected()) {
    if(lastMqttAttempt==0 || (uint32_t)(now-lastMqttAttempt)>=MQTT_RETRY_MS) {
      lastMqttAttempt=now;
      Serial.printf("[S3/MQTT] IP=%s conectando %s:%u\n",WiFi.localIP().toString().c_str(),MQTT_HOST,MQTT_PORT);
      String clientId=String("iotmotor_s3_")+String((uint32_t)ESP.getEfuseMac(),HEX);
      if(mqtt.connect(clientId.c_str(),statusTopic,0,true,"offline")) {
        publishStatus("online");publishCapabilities();publishNetworks();
        // Assinou os comandos: esta versao pode receber a proxima atualizacao.
        if(mqtt.subscribe(commandTopic,1))ota::confirmarVersao();
        lastDiagnosticsPublish=now;
        mqtt.subscribe(quadroTelemetryTopic,0);mqtt.subscribe(acquisitionTopic,1);publishAlarms();publishAuth();publishAlarmLog();
        for(uint8_t d=0;d<historico::DIAS;d++)publishHistory(d);
        pedirBeep(2,buzzerHz,70);  // Dois bipes sempre: placa conectada ao broker.
        Serial.printf("[S3/MQTT] conectado, publicando %s\n",telemetryTopic);
      } else Serial.printf("[S3/MQTT] falha state=%d\n",mqtt.state());
    }
    delay(2);return;
  }

  mqtt.loop();
  verificarDesarme(millis());
  now=millis();
  if(lastDiagnosticsPublish==0 ||
     (uint32_t)(now-lastDiagnosticsPublish)>=DIAGNOSTICO_PUBLICAR_MS) {
    lastDiagnosticsPublish=now;
    publishNetworks();
  }
  if(lastPublish==0 || (uint32_t)(now-lastPublish)>=publishMs) {
    lastPublish=now;publishTelemetry();
  }
  if(alarmes::eventosMudaram)publishAlarmLog();
  delay(2);
}
