frahncky/IoTMotor/esp32/iotmotor_esp32/iotmotor_esp32_s3_sensores/alarm_list.h

#pragma once
// Lista de alarmes gravada na placa (NVS), editada pelo painel.
//
// Cada alarme diz de onde vem a grandeza, qual e ela, se dispara acima ou
// abaixo do limite, e o limite. As grandezas do quadro de comando (tensao,
// corrente, potencia...) chegam pela telemetria do outro ESP32, que esta placa
// assina; as de vibracao e temperatura sao medidas aqui mesmo.
//
// Um alarme so vale com leitura recente: valor velho nao dispara nem silencia.
#include <Arduino.h>
#include <ArduinoJson.h>
#include <Preferences.h>

namespace alarmes {

constexpr uint8_t MAX_ALARMES = 8;
constexpr size_t MAX_ID_ALARME = 12;
constexpr size_t MAX_CAMPO = 16;
constexpr uint32_t VALIDADE_MS = 15000;  // Leitura mais velha que isso e ignorada.

struct Alarme {
  char id[MAX_ID_ALARME + 1] = "";
  char campo[MAX_CAMPO + 1] = "";  // voltage, current, power, vibration_mms, temperature...
  bool doQuadro = false;           // true = vem do ESP32 de comandos.
  bool acima = true;               // true = dispara acima do limite.
  float limite = 0;
  bool habilitado = true;
  // Desarme: com o motor ligado, disparar manda o quadro desligar. Escolhido
  // por alarme, desligado por padrao.
  bool desarma = false;
  bool disparado = false;          // Estado atual, nao gravado.
};

inline Alarme lista[MAX_ALARMES];
inline uint8_t total = 0;

// ---- Registro dos ultimos disparos ----
// Cada episodio guarda quando comecou, com que valor, e quando acabou. Fica na
// memoria volatil: reiniciou a placa, o registro recomeca. Serve para contar o
// que aconteceu durante o ensaio, nao como historico permanente.
constexpr uint8_t MAX_EVENTOS = 10;

struct Evento {
  char id[MAX_ID_ALARME + 1] = "";
  char campo[MAX_CAMPO + 1] = "";
  float valor = 0;      // Leitura no instante em que disparou.
  uint32_t inicio = 0;  // Segundos UTC, ou 0 se a placa ainda nao tinha hora.
  uint32_t fim = 0;     // 0 enquanto o alarme continua disparado.
  uint32_t inicioMs = 0;
  uint32_t fimMs = 0;
  bool desarmou = false;  // Este episodio mandou o quadro desligar o motor.
};

inline Evento eventos[MAX_EVENTOS];
inline uint8_t totalEventos = 0;
inline bool eventosMudaram = false;

inline void anotarInicio(const Alarme& a, float valor, uint32_t agora, uint32_t utc) {
  if (totalEventos == MAX_EVENTOS) {  // Fila cheia: o mais antigo sai.
    for (uint8_t i = 0; i + 1 < MAX_EVENTOS; ++i) eventos[i] = eventos[i + 1];
    --totalEventos;
  }
  Evento& e = eventos[totalEventos++];
  e = Evento();
  strncpy(e.id, a.id, MAX_ID_ALARME);
  strncpy(e.campo, a.campo, MAX_CAMPO);
  e.valor = valor;
  e.inicio = utc;
  e.inicioMs = agora;
  eventosMudaram = true;
}

// O episodio aberto deste alarme desligou o motor.
inline void anotarDesarme(const char* id) {
  for (int8_t i = totalEventos - 1; i >= 0; --i) {
    if (strcmp(eventos[i].id, id) || eventos[i].fimMs) continue;
    if (!eventos[i].desarmou) {
      eventos[i].desarmou = true;
      eventosMudaram = true;
    }
    return;
  }
}

inline void anotarFim(const Alarme& a, uint32_t agora, uint32_t utc) {
  for (int8_t i = totalEventos - 1; i >= 0; --i) {
    if (strcmp(eventos[i].id, a.id) || eventos[i].fimMs) continue;
    eventos[i].fim = utc;
    eventos[i].fimMs = agora;
    eventosMudaram = true;
    return;
  }
}

// Ultimos valores recebidos do quadro de comando, com o instante da leitura.
inline StaticJsonDocument<512> medidasDoQuadro;
inline uint32_t medidasDoQuadroEm = 0;

inline int indiceDe(const char* id) {
  for (uint8_t i = 0; i < total; ++i)
    if (!strcmp(lista[i].id, id)) return i;
  return -1;
}

// Oito alarmes com todos os campos passam de 1,5 KB no ArduinoJson.
constexpr size_t TAMANHO_DOC_ALARMES = 2048;

inline void gravar() {
  DynamicJsonDocument doc(TAMANHO_DOC_ALARMES);
  JsonArray array = doc.to<JsonArray>();
  for (uint8_t i = 0; i < total; ++i) {
    JsonObject item = array.createNestedObject();
    item["id"] = lista[i].id;
    item["field"] = lista[i].campo;
    item["board"] = lista[i].doQuadro ? "command" : "sensors";
    item["above"] = lista[i].acima;
    item["limit"] = lista[i].limite;
    item["on"] = lista[i].habilitado;
    if (lista[i].desarma) item["trip"] = true;
  }
  String texto;
  serializeJson(doc, texto);
  Preferences memoria;
  if (!memoria.begin("iot-alarmes", false)) return;
  memoria.putString("lista", texto);
  memoria.end();
}

inline bool lerDeJson(JsonVariantConst origem, Alarme& destino) {
  const char* id = origem["id"] | "";
  const char* campo = origem["field"] | "";
  if (!id[0] || strlen(id) > MAX_ID_ALARME || !campo[0] || strlen(campo) > MAX_CAMPO) return false;
  if (!origem["limit"].is<float>()) return false;
  strncpy(destino.id, id, MAX_ID_ALARME);
  destino.id[MAX_ID_ALARME] = '\0';
  strncpy(destino.campo, campo, MAX_CAMPO);
  destino.campo[MAX_CAMPO] = '\0';
  destino.doQuadro = !strcmp(origem["board"] | "sensors", "command");
  destino.acima = origem["above"] | true;
  destino.limite = origem["limit"].as<float>();
  destino.habilitado = origem["on"] | true;
  destino.desarma = origem["trip"] | false;
  destino.disparado = false;
  return isfinite(destino.limite);
}

inline bool salvar(JsonVariantConst origem, const char*& motivo) {
  Alarme alarme;
  if (!lerDeJson(origem, alarme)) {
    motivo = "alarme invalido: confira grandeza e limite";
    return false;
  }
  const int existente = indiceDe(alarme.id);
  if (existente >= 0) {
    alarme.disparado = lista[existente].disparado;
    lista[existente] = alarme;
  } else {
    if (total >= MAX_ALARMES) {
      motivo = "limite de alarmes atingido";
      return false;
    }
    lista[total++] = alarme;
  }
  gravar();
  motivo = existente >= 0 ? "alarme atualizado" : "alarme criado";
  return true;
}

inline bool remover(const char* id, const char*& motivo) {
  const int i = indiceDe(id ? id : "");
  if (i < 0) {
    motivo = "alarme nao encontrado";
    return false;
  }
  for (uint8_t j = i; j + 1 < total; ++j) lista[j] = lista[j + 1];
  --total;
  gravar();
  motivo = "alarme removido";
  return true;
}

// Alarmes iniciais: os mesmos limites que a placa usava antes da lista.
inline void semear(float vibracao, float temperatura) {
  total = 0;
  Alarme vib;
  strcpy(vib.id, "vib");
  strcpy(vib.campo, "vibration_mms");
  vib.limite = vibracao;
  lista[total++] = vib;
  Alarme temp;
  strcpy(temp.id, "temp");
  strcpy(temp.campo, "temperature");
  temp.limite = temperatura;
  lista[total++] = temp;
  gravar();
}

inline void carregar(float vibracaoPadrao, float temperaturaPadrao) {
  Preferences memoria;
  String texto;
  if (memoria.begin("iot-alarmes", true)) {
    texto = memoria.getString("lista", "");
    memoria.end();
  }
  total = 0;
  if (texto.length()) {
    DynamicJsonDocument doc(TAMANHO_DOC_ALARMES);
    if (!deserializeJson(doc, texto)) {
      for (JsonVariantConst item : doc.as<JsonArrayConst>()) {
        if (total >= MAX_ALARMES) break;
        Alarme alarme;
        if (lerDeJson(item, alarme)) lista[total++] = alarme;
      }
    }
  }
  if (!total) {
    semear(vibracaoPadrao, temperaturaPadrao);
  } else {
    // Vibracao so em mm/s (ISO 10816): alarmes antigos de aceleracao em g
    // (vibration_peak, vibration) viram alarmes de vibracao com o limite
    // padrao, mantendo ligado/desligado e desarme. Um limite em g nao tem
    // equivalente em mm/s.
    bool mudou = false;
    for (uint8_t i = 0; i < total; ++i) {
      if (strcmp(lista[i].campo, "vibration_peak") && strcmp(lista[i].campo, "vibration")) continue;
      strcpy(lista[i].campo, "vibration_mms");
      lista[i].limite = vibracaoPadrao;
      mudou = true;
    }
    if (mudou) gravar();
  }
  Serial.printf("[ALARMES] %u na placa\n", total);
}

// Guarda a telemetria do quadro de comando para os alarmes eletricos.
// Recebe a telemetria ja lida (uma leitura so, feita por quem assina o topico).
inline void receberMedidasDoQuadro(JsonVariantConst entrada, uint32_t agora) {
  medidasDoQuadro.clear();
  for (const char* campo : {"voltage", "current", "power", "energy", "frequency", "pf", "starts_hour"})
    if (entrada[campo].is<float>()) medidasDoQuadro[campo] = entrada[campo].as<float>();
  medidasDoQuadroEm = agora;
}

// Valor atual de um campo, se houver leitura valida e recente.
inline bool valorDe(const Alarme& alarme, uint32_t agora, bool mpuOk, bool tempOk,
                    float vibracaoMms, float temperatura, float& saida) {
  if (alarme.doQuadro) {
    if (!medidasDoQuadroEm || agora - medidasDoQuadroEm > VALIDADE_MS) return false;
    if (!medidasDoQuadro[alarme.campo].is<float>()) return false;
    saida = medidasDoQuadro[alarme.campo].as<float>();
    return true;
  }
  // Velocidade RMS em mm/s (ISO 10816); NAN enquanto a janela nao tem leitura.
  if (!strcmp(alarme.campo, "vibration_mms")) {
    if (!mpuOk || !isfinite(vibracaoMms)) return false;
    saida = vibracaoMms;
    return true;
  }
  if (!strcmp(alarme.campo, "temperature")) {
    if (!tempOk) return false;
    saida = temperatura;
    return true;
  }
  return false;
}

// Avalia todos e devolve true se algum disparou. 'utc' vem do relogio da placa
// (0 enquanto o NTP nao responde) e so serve para carimbar o registro.
inline bool avaliar(uint32_t agora, bool mpuOk, bool tempOk, float vibracaoMms,
                    float temperatura, uint32_t utc = 0) {
  bool algum = false;
  for (uint8_t i = 0; i < total; ++i) {
    Alarme& a = lista[i];
    float valor = 0;
    const bool antes = a.disparado;
    a.disparado = a.habilitado &&
                  valorDe(a, agora, mpuOk, tempOk, vibracaoMms, temperatura, valor) &&
                  (a.acima ? valor > a.limite : valor < a.limite);
    if (a.disparado && !antes) anotarInicio(a, valor, agora, utc);
    else if (!a.disparado && antes) anotarFim(a, agora, utc);
    algum = algum || a.disparado;
  }
  return algum;
}

inline void descreverEventos(JsonDocument& doc) {
  JsonArray array = doc.createNestedArray("events");
  for (uint8_t i = 0; i < totalEventos; ++i) {
    JsonObject item = array.createNestedObject();
    item["id"] = eventos[i].id;
    item["field"] = eventos[i].campo;
    item["value"] = eventos[i].valor;
    if (eventos[i].inicio) item["start"] = eventos[i].inicio;
    if (eventos[i].fim) item["end"] = eventos[i].fim;
    item["open"] = eventos[i].fimMs == 0;
    if (eventos[i].desarmou) item["trip"] = true;
    // Duracao em segundos vale mesmo sem hora: millis() nao depende do NTP.
    const uint32_t ate = eventos[i].fimMs ? eventos[i].fimMs : millis();
    item["seconds"] = (ate - eventos[i].inicioMs) / 1000;
  }
  doc["max"] = MAX_EVENTOS;
}

inline void descrever(JsonDocument& doc) {
  JsonArray array = doc.createNestedArray("alarms");
  for (uint8_t i = 0; i < total; ++i) {
    JsonObject item = array.createNestedObject();
    item["id"] = lista[i].id;
    item["field"] = lista[i].campo;
    item["board"] = lista[i].doQuadro ? "command" : "sensors";
    item["above"] = lista[i].acima;
    item["limit"] = lista[i].limite;
    item["on"] = lista[i].habilitado;
    item["trip"] = lista[i].desarma;
    item["firing"] = lista[i].disparado;
  }
  doc["max"] = MAX_ALARMES;
}

}  // namespace alarmes
