frahncky/IoTMotor/(commit log)

2026-03-07 Atualiza app IoTMotor, simuladores e firmware ESP32
2026-03-07 foi desenvolvida a funcionalidade de segundo plano para o app
2026-05-07 Implementa alertas e exportacao de telemetria
2026-05-07 Adiciona persistencia e filtros de historico
2026-05-07 Ajusta textos das telas de historico e configuracoes
2026-05-07 correções de acentuação e português
2026-05-08 Refatoração: limpeza de imports, null checks, dependência shared_preferences e correção de warnings em settings_tab, motor_control_page e mqtt_profiles_provider
2026-05-10 implementation of motor stress test
2026-09-16 feat: add Cloudflare Pages read-only dashboard for ESP32 commands firmware
2026-09-16 feat: connect Cloudflare monitor to ESP32-01 MQTT telemetry using WSS
2026-09-16 fix(dashboard): use Mosquitto WSS and diagnose broker versus ESP32 failures
2026-09-16 feat(esp32): full demo telemetry, optional real sensors and locally armed bench commands
2026-09-16 docs(esp32): explain bench arming, real sensor wiring and MQTT limitations
2026-09-16 feat(esp32-01): use real PZEM readings by default for electrical telemetry
2026-09-16 feat(esp32-s3): independent real MPU6050 and DS18B20 telemetry on esp32-02
2026-09-16 feat(web): aggregate PZEM ESP32 and S3 sensor data with app-style plots and guarded bench controls
2026-09-16 feat(web): two-device IoTMotor dashboard with PZEM/S3 charts and guarded bench controls
2026-09-16 test(web): validate two-device MQTT payloads, derived powers and broker config
2026-09-16 docs(web): document ESP32 PZEM plus ESP32-S3 sensor topology and guarded bench commands
2026-09-16 docs(esp32): align bench setup with real PZEM on ESP32-01 and S3 sensor module
2026-09-16 docs(esp32-s3): document independent vibration and temperature sensor wiring
2026-09-16 feat(web): add dedicated four-relay and LCD 20x4 monitoring screen
2026-09-16 feat(web): render four commanded relay states and LCD shadow with honest fallback
2026-09-16 build(esp32): generate read-only LCD and relay MQTT mirror from functioning four-relay firmware
2026-09-16 ci(esp32): package original four-relay sketch with read-only LCD and GPIO telemetry mirror
2026-09-16 ci(web): check four-relay LCD monitoring page and its JavaScript
2026-09-16 test(web): verify exact LCD buffer and commanded pin states without publishing commands
2026-09-16 stage sanitized working ESP32 firmware for canonical consolidation
2026-09-16 ci: inspect staged sanitized firmware before consolidating main
2026-09-16 docs: define the two supported ESP32 modules and local-only relay controls
2026-09-16 ci: install staged firmware as the single ESP32-01 source
2026-09-16 feat: set tested v6 four-relay LCD firmware as primary ESP32 source
2026-09-16 feat(web): discover ESP32 LAN panel for existing on/off relay controls
2026-09-16 ci(web): install and verify LAN relay-control entry on dashboard
2026-09-16 chore: remove superseded single-device dashboard prototype
2026-09-16 chore: remove tests for retired single-device dashboard
2026-09-16 chore: remove superseded dashboard v2 prototype
2026-09-16 chore(esp32): remove retired motor prototype
2026-09-16 chore(esp32): remove retired all-in-one test firmware
2026-09-16 test(web): validate local on-off panel discovery from fresh four-relay telemetry
2026-09-16 test(web): cover local ESP32 on-off navigation and canonical dashboard
2026-09-16 feat(web): configure relay start profile on same dashboard and use same-origin LAN control
2026-09-16 feat(esp32): nonblocking LAN-only four-relay start profiles with physical bench enable and stop
2026-09-16 build: generate one-screen LAN dashboard and integrate configurable relay profiles into canonical ESP32 firmware
2026-09-16 ci(esp32): build same-screen relay controls and firmware with LAN-only start profiles
2026-09-16 feat(iotmotor): configure start mode and K1-K4 on same ESP32 dashboard
2026-09-16 security(esp32): require same-origin browser for relay starts and block cross-site actuation
2026-09-16 ci(esp32): idempotent dashboard sync and same-origin relay controls
2026-09-16 fix(iotmotor): same-origin LAN profiles and synchronized dashboard
    [iotmotor_esp32_comandos.ino, iotmotor_profiles.h]
2026-09-16 fix(web): reuse existing Ligar and Desligar buttons for configured LAN relay profiles
2026-09-16 fix(web): prevent telemetry renderer from overriding original relay-control buttons
2026-09-16 ci(web): ensure original Ligar and Desligar buttons own same-screen LAN control
2026-09-16 fix(web): use original Ligar and Desligar buttons for LAN profiles
2026-09-16 feat(esp32): add signed MQTT commands with on-device secret and replay protection
2026-09-16 feat(web): signed MQTT start and stop from existing dashboard buttons
2026-09-16 build: install signed MQTT start/stop and synchronize ESP32 web assets
2026-09-16 feat(iotmotor): operate existing on-off buttons over signed MQTT
2026-09-16 ci(esp32): compile canonical ESP32 firmware for four-relay MQTT controls
2026-09-16 fix(web): add explicit diagnostic for disabled MQTT relay controls
    [diagnose_disabled_buttons.py]
2026-09-16 ci(web): publish precise disabled-button diagnostics and synchronize ESP32 site
2026-09-16 ci(web): test current dashboard rather than removed tab prototype
2026-09-16 fix(web): explain missing firmware, MQTT, key and jumper on disabled buttons
2026-09-17 feat(web): control ESP32 via open MQTT without manual key
2026-09-17 feat(esp32): accept MQTT start-stop profiles without HMAC or stored key
2026-09-17 refactor(esp32): retain relay profiles without legacy HTTP routes
2026-09-17 refactor(esp32): remove embedded HTTP dashboard; retain PZEM LCD and open MQTT relay control
2026-09-17 refactor(esp32): delete embedded HTML and JavaScript formerly served by ESP32
2026-09-17 refactor(web): keep one-page relay profile selector and remove HTTP local controls
2026-09-17 test: check MQTT controls without HMAC and absence of embedded ESP32 web server
2026-09-17 feat(web): show MQTT start-stop controls without key or ESP32 local-page instructions
2026-09-17 fix(esp32): remove GPIO32 jumper requirement from MQTT relay profiles
    [iotmotor_profiles.h]
2026-09-17 fix(mqtt): accept relay starts without GPIO32 jumper or command key
    [iotmotor_mqtt_control.h]
2026-09-17 fix(esp32): eliminate GPIO32 arm from MQTT-only firmware
    [iotmotor_esp32_comandos.ino]
2026-09-17 fix(web): remove physical arming language from relay control panel
2026-09-17 docs: document MQTT-only relay control without key, local web server or jumper
2026-09-17 fix(esp32): fit LCD energy line in 20 columns, update docs and compile S3 in CI
    - LCD line 3 was 21 chars, truncating "kWh"; energy width 8 -> 7 (mirror in hardware-mirror.js)
    - Rewrite LEIA-ME-BANCADA.md and esp32/README.md to match MQTT four-relay firmware
    - CI now also compiles the ESP32-S3 sensor firmware
    [iotmotor_esp32_comandos.ino]
2026-09-17 feat(web): show per-device connection status on dashboard
    Top badges now combine recent telemetry with retained online/offline (LWT)
    status: connected, online waiting for data, disconnected, no data, broker down.
2026-09-17 feat(web): declutter dashboard and name contactors CNT 1-CNT 4
    - Remove explanatory paragraphs, footer, raw status/counters, hidden button,
    duplicated feedback and LCD copy from the main page
    - Contactor state shown as CNT 1-4 chips; start config placed before buttons
    - Show firmware start_phase as "Etapa" instead of raw mode codes
    - Rename K1-K4 to CNT 1-CNT 4 on hardware page, messages and README
2026-09-17 fix(esp32): connect MQTT over WebSocket port 8080 on IFMA_IOT network
    The IFMA_IOT firewall blocks MQTT ports 1883/8883 (rc=-2), while
    test.mosquitto.org:8080 (MQTT over WebSocket) is reachable.
    - Add MqttWebSocketClient, an Arduino Client adapter so PubSubClient
    works over ws:// without new libraries
    - Use it in ESP32-01 (v10-mqtt-websocket) and ESP32-S3 firmwares
    - Verified on ESP32-01: telemetry published and stop command acknowledged
    - CI checks the adapter is identical in both firmware folders; docs updated
    [iotmotor_esp32_comandos.ino, iotmotor_esp32_s3_sensores.ino, mqtt_websocket_client.h]
2026-09-17 feat(esp32): detect LCD I2C address at boot and report missing display
    - Scan the I2C bus and use the PCF8574 address found (prefers 0x27, accepts 0x3F)
    - Print found devices and a wiring hint on serial when no LCD responds
    - Keep LCD cache for MQTT telemetry even when no display is attached
    [iotmotor_esp32_comandos.ino]
2026-09-17 fix(esp32-s3): stop repeated sensor warnings and verify MPU6050 WHO_AM_I
    - Retry MPU6050 every 5 s with a timer instead of now%5000 window, which
    re-initialized several times per window and flooded the serial log
    - Report missing MPU6050/DS18B20 once, and again only when state changes
    - Check WHO_AM_I (0x68) before treating the MPU6050 as present
    [iotmotor_esp32_s3_sensores.ino]
2026-09-17 fix(esp32-s3): accept MPU6500 clones and locate DS18B20 pin automatically
    - Revert the strict WHO_AM_I==0x68 check that rejected the MPU6500 module in
    use (id 0x70) and broke vibration readings; log the id instead
    - Search the DS18B20 on GPIO4 and the other free pins, accepting only a ROM
    read with valid CRC, and report the pin found or a wiring hint
    [iotmotor_esp32_s3_sensores.ino]
2026-09-17 fix(esp32): start relays instead of cancelling the run as timed out
    The MQTT callback runs after loop() reads millis(), so momentoPartida could be
    ahead of "agora". The unsigned subtraction wrapped to a huge value, exceeded
    LIMITE_BANCADA_MS and stopped the run before any relay switched on.
    - Compare elapsed time with a signed helper in iotmotor_profiles.h
    - Read Wi-Fi credentials from an optional local wifi_local.h (gitignored),
    with wifi_local.exemplo.h as template, so passwords stay off GitHub
    - Verified on hardware: direct start and the full star-delta sequence
    [iotmotor_esp32_comandos.ino, iotmotor_esp32_s3_sensores.ino, iotmotor_profiles.h, wifi_local.exemplo.h]
2026-09-17 feat(esp32): raise bench auto-off limit from 60 s to 5 minutes
    Relays dropping out mid-test were the safety timeout expiring, not a fault.
2026-09-18 feat(esp32): tolerate 15 s without MQTT/Wi-Fi and log reset reason
    Measured on the public broker: 2 dropouts, 2 gaps of 8-10 s and 1 reboot in
    10 minutes, which cut running tests short.
    - Keep outputs energized for up to TOLERANCIA_SEM_LINK_MS (15 s) without link
    - Report esp_reset_reason on serial and in telemetry (reset_reason) to tell
    brownouts from crashes
    [iotmotor_esp32_comandos.ino, iotmotor_profiles.h]
2026-09-18 fix(web): make Desconectar also stop the command client
    The page keeps two MQTT clients; Desconectar ended only the telemetry one, so
    Ligar/Desligar kept publishing to the broker after the user disconnected.
    Verified in a headless browser: after Desconectar the buttons are disabled and
    no command is published.
2026-09-18 feat(web): open the dashboard disconnected until the user connects
    Both MQTT clients now start idle and are driven by the Conectar/Desconectar
    button, so reopening the page never resumes commanding on its own.
    Verified in a headless browser: no publish and disabled buttons on load;
    after Conectar the badges turn live and Ligar publishes one command.
2026-09-18 feat(esp32): over-the-air updates and multi-network Wi-Fi
    Boards move between networks, so updates must not depend on being on the same
    LAN as the PC, and credentials must cover more than one access point.
    - ota_update.h downloads the firmware over HTTPS from the fixed GitHub release
    firmware-latest; the MQTT "update" action only triggers it and never carries
    the URL, since the broker is public
    - ESP32-01 refuses to update while outputs are on; ESP32-S3 now subscribes to
    its command topic just for updates
    - WiFiMulti with up to four networks declared in wifi_local.h
    - New workflow publish-firmware.yml builds both .bin files and uploads them to
    the firmware-latest release on every pu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
    [iotmotor_esp32_comandos.ino, iotmotor_esp32_s3_sensores.ino, iotmotor_mqtt_control.h, ota_update.h, wifi_local.exemplo.h]
2026-09-18 feat: add Wi-Fi provisioning and firmware update from the app and the dashboard
    Passwords must never cross the public broker, so the page and the app only ask
    the board to open its own configuration network; the credentials are typed
    there, over the board's AP.
    - wifi_portal.h: captive portal (WiFiManager) opened when no known network
    answers at boot or on the MQTT "wifi_portal" action; the network is saved in
    NVS and joins the WiFiMulti list
    - Both firmwares refuse portal/update while outputs are energized
    - Dashboard: "Cadastrar Wi-Fi" and "Atualizar firmware" buttons, enabled only
    when connected with all contactors off
    - App: sendMaintenanceCommand in the MQTT service and a mainten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
    [iotmotor_esp32_comandos.ino, iotmotor_esp32_s3_sensores.ino, iotmotor_mqtt_control.h, wifi_portal.h]
2026-09-18 feat(app): update the Android app over the air and fix the APK build
    - Bump Gradle wrapper to 8.14.3 and AGP to 8.9.1: Flutter now requires 8.14+,
    which was breaking the APK workflow
    - CI publishes IoTMotor.apk and app-latest.json to the app-latest release and
    stamps the build into the APK with --dart-define=IOTMOTOR_BUILD
    - AppUpdateService compares that stamp with the published one; the settings tab
    gets an "Atualizar este app" button that offers the APK download
    - Android only: iOS installs come from the App Store or TestFlight
2026-09-18 @ fix(android): require AGP 8.11.1 for the current Flutter stable
    The GitHub runner ships a newer Flutter, whose Gradle plugin refuses AGP below
    8.11.1.
    @
2026-09-18 @ fix(android): require Kotlin 2.2.20 for the current Flutter stable
    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
2026-09-19 feat: saved, user-ordered Wi-Fi list on the boards and a Wi-Fi tab in the dashboard
    Boards kept asking for the network after every power-up, and configuring them
    meant leaving the dashboard for the board's own portal page.
    - wifi_store.h: up to 8 networks in NVS, tried in the user's priority order
    among the visible ones; seeded once from wifi_local.h and the old portal
    entry, then owned by the user
    - MQTT actions wifi_list, wifi_add, wifi_remove and wifi_order; the list (no
    passwords) is retained on iotmotor/<device>/wifi
    - Passwords never cross the public broker in clear text: each board keeps a
    P-256 key in NVS and publishes the public half; the page encrypts with
    ECDH + SHA-256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
    [iotmotor_esp32_comandos.ino, iotmotor_esp32_s3_sensores.ino, iotmotor_mqtt_control.h, wifi_portal.h, wifi_store.h]
2026-09-19 feat: keep the board's own Wi-Fi network, configurable from the dashboard, and keep networks across OTA
    - The board's access point (portal) stays: name and password are now set in
    the "Wi-Fi das placas" tab (wifi_ap, password encrypted like the others),
    and a button opens it on demand; it still opens by itself when no listed
    network answers
    - First boot of the new list also imports the network remembered by the Wi-Fi
    driver, so an over-the-air update does not drop the board off its network
2026-09-19 fix(web): update each board's firmware from the Wi-Fi tab
    The "Atualizar firmware" button only targeted the command board, so the S3
    never got the Wi-Fi list firmware and its tab stayed empty. The Wi-Fi tab now
    has a per-board update button, available even before the board publishes a
    list, and the waiting message points to it.
    Bump firmware_version (v11-wifi-list, s3-sensors-1.2-wifi-list) so old and new
    builds can be told apart.
    [iotmotor_esp32_comandos.ino, iotmotor_esp32_s3_sensores.ino]
2026-09-19 fix(app): switch the contactors with the firmware's v:1 command format
    "Ligar" published a broadcast command_request on a topic the firmware does not
    subscribe to, and the app read motor state from motor_on, which the firmware no
    longer sends.
    - sendBenchCommand publishes v:1 start/stop on iotmotor/<device>/command with
    an increasing seq, like the dashboard
    - Start takes the boot id from recent telemetry and uses the dashboard's
    default profiles: direct = CNT 1; star-delta = CNT 1/2/3 with 5 s in star
    - Motor state comes from the relays array; start is refused while a contactor
    is on or without telemetry from the last 10 s
    - Verified against the real ESP32-01: start accepted, CNT 1 on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
2026-09-19 fix(app): stable signing key, Ligar/Desligar from the bench state, contactors per start type
    1. Every APK had a different signature (debug key per machine or CI runner), so
    Android refused to update over the installed app. Release builds now sign
    with a fixed key from android/key.properties (kept out of Git); CI restores
    it from repository secrets, refuses to publish without it, prints the
    certificate, and raises the versionCode on every build.
    2. The toggle read the "selected device", which in auto mode flips between the
    ESP32-01 and the S3; it now follows the contactors of the command board.
    3. Each start type stores its contactors: direct = any set of CNT 1-4;
    star-delta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
2026-09-19 fix(app): keep the typed broker host instead of the MQTT profile on restart
    The app always builds its controller from the active MQTT profile with
    loadSettings:false, so the stored settings file was never read: a broker typed
    in the settings tab was replaced by the profile value on the next launch.
    - withMqttConfig now loads the stored settings over the profile, and records
    which profile they belong to
    - Switching profiles still wins: stored values are ignored when the active
    profile id changed
    - New test covers both directions; path_provider_platform_interface and
    plugin_platform_interface become dev dependencies for it
2026-09-20 feat(esp32-s3): local LED and buzzer alarm, tuned from the dashboard
    The S3 board carries an RGB LED (GPIO16/17/18) and a passive buzzer (GPIO42),
    idle since the module-2 firmware was dropped.
    - The board decides on its own: green normal, red above a limit, blue with no
    valid sensor; the buzzer beeps at 2 kHz while a limit is exceeded
    - Limits (0.50 g and 60 C, from the old firmware) live in NVS and are set from
    the new "Alarme do ESP32-S3" panel; alarm_test lights everything for 1.5 s
    - Telemetry carries alarm_enabled, alarm_active and both limits
    - The DS18B20 pin search no longer probes 16/17/18/42
    [iotmotor_esp32_s3_sensores.ino]
2026-09-20 feat: start profiles with per-contactor timing, stored on the board, and a more useful LCD
    Each client kept its own start list, so a profile created in the dashboard was
    unknown to the app. The list now lives on the ESP32-01 (NVS) and is published
    retained on iotmotor/esp32-01/profiles, so both clients read and edit the same
    one.
    - A profile gives every contactor the instant it closes and the instant it
    opens; direct and star-delta are just particular cases of that timeline
    - MQTT actions profile_list, profile_save and profile_remove; start takes
    {profile:"id"}, and the old mode direct/sequence commands still work
    - Dashboard: profile picker, summary of the timings and an editor writing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
2026-09-20 @ fix(esp32): keep every LCD line inside the 20 columns
    The running profile ran into the remaining time with no space between them,
    and the energy line was 21 columns, so the display cut it.
    - Profile name padded to 12 columns, then the remaining seconds and the link
    - Contactors listed as "1,2" instead of the unreadable "12--"
    - Frequency moved next to the contactors; energy stays in the dashboard
    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
    [iotmotor_esp32_comandos.ino]
2026-09-20 feat(esp32-s3): short beeps outside emergencies, with a switch in the dashboard
    The buzzer only made noise when a limit was exceeded, so nothing told the
    bench that a command had arrived or that the board was online.
    - One beep on every command received, two when the board joins the broker;
    the "Bipes de eventos" switch stores the choice on the board
    - buzzer_beep plays a beep on demand (frequency, length and count) and the
    dashboard gets a "Bipar" button
    - Beeps never fight the alarm: a limit being exceeded cancels them
    [iotmotor_esp32_s3_sensores.ino]
2026-09-20 feat(app): share the board's start profiles, with per-contactor timing
    The app kept its own start list, so a profile created there never reached the
    dashboard (or the board). It now reads the list the ESP32-01 publishes and
    writes changes back to it, so both clients always show the same profiles.
    - Subscribes to <prefix>/+/profiles and <prefix>/+/command_ack; the list from
    the board replaces the local one, and a bad or empty payload keeps what was
    already shown
    - The editor now asks, per contactor, when it closes and when it opens
    (0 = stays on until stop), the same model as the dashboard, and saves with
    profile_save; removing uses profile_remove
    - Older local profiles convert to ti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
2026-09-20 feat(esp32-s3): buzzer_probe sweeps the free pins to find the buzzer
    The board accepts the beep command but nothing is heard, so either the pin
    differs from the GPIO42 inherited from the old module-2 firmware, or the
    buzzer is an active one that tone() cannot drive.
    The probe walks the free pins, driving each one first with tone (passive
    buzzer) and then with a steady high level (active buzzer), announcing every
    step on command_ack so the sound can be matched to a pin.
    [iotmotor_esp32_s3_sensores.ino]
2026-09-20 @ fix(esp32-s3): run the buzzer probe from the main loop
    Calling mqtt.loop() from inside the command callback re-entered PubSubClient
    and corrupted the published acks, so the sweep broke the client that listened
    to it. The probe is now a step machine advanced by the main loop, which also
    keeps the MQTT keepalive during the sweep.
    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
    [iotmotor_esp32_s3_sensores.ino]
2026-09-20 docs(esp32-s3): record the silent buzzer as an electrical fault
    The firmware drives GPIO42 and acknowledges the command, and the pin sweep
    found no pin that makes a sound, so the cause is the wiring. Documents how to
    re-run buzzer_probe and what to change once the buzzer is rewired.
2026-09-20 @ fix(web): stop the control buttons from flickering on short broker drops
    The public broker drops for a few seconds and the client reconnects in four,
    but the page disabled Ligar/Desligar and the profile buttons the instant the
    socket went down, so they blinked during normal use.
    - A drop only disables the buttons if the client is still down after 6 s, and
    the feedback says "reconectando" meanwhile
    - Telemetry counts as recent for 25 s instead of 10 s: measured gaps on the
    public broker reach 20 s, which kept the maintenance buttons disabled
    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
2026-09-20 feat: follow the running start profile in the app and the dashboard
    Starting a profile anywhere now moves both clients to it, so what is shown
    matches what the bench is doing, even when someone else pressed Ligar.
    - The board already reports the running profile id in telemetry; the dashboard
    picker switches to it and says which one is running, and the app resolves its
    selected start type from it before falling back to the mode string
    - Stopping keeps the last choice instead of jumping back
    - Bench fields (contactors, session and running profile) are read before the
    active configuration is required, so they work as soon as messages arrive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
2026-09-20 @ feat: friendly board names, less clutter on the page and on the LCD
    - Starting from the app sent the legacy mode/mask command, which the board ran
    as a throwaway profile, so the dashboard had nothing to switch to; the app
    now sends the profile id and both clients follow each other
    - The boards are called "Quadro de comando" and "Sensores do motor" across the
    page; the technical ids stay in the field labels and in the badge tooltips
    - Dropped the public-broker warning and trimmed the Wi-Fi hints
    - LCD line 1 shows only the running profile: the countdown and the "MQ" mark
    were noise next to the connection state already shown when idle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
    [iotmotor_esp32_comandos.ino]
2026-09-20 feat(app): download and install the update without leaving the app
    "Atualizar este app" opened the browser and left the user to find the file in
    Downloads and start the install by hand.
    - The app downloads the published APK with a progress bar and hands it to
    Android PackageInstaller through a method channel
    - Android always shows its own confirmation, and asks once for "install
    unknown apps"; when that is missing the app opens the right settings screen
    - If anything fails, the old browser download is offered as a fallback
    [MainActivity.kt]
2026-09-20 feat(alarmes): lista de alarmes na placa, com corrente e tensão
    Os limites fixos de vibração e temperatura viraram uma lista gravada no
    S3 (até 8 alarmes em NVS). Cada alarme aponta a grandeza, a placa de
    origem, se dispara acima ou abaixo e o limite.
    Para vigiar grandezas elétricas, o S3 passa a assinar a telemetria do
    quadro de comando: tensão, corrente, potência, frequência e fator de
    potência acendem o mesmo LED e tocam o mesmo buzzer. Leitura mais velha
    que 15 s não dispara nem silencia.
    A lista fica retida em iotmotor/esp32-02/alarms e a telemetria traz
    alarms_firing. No painel, cada linha tem limite editável, interruptor e
    botões de gravar/remover, com um formulário par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
    [alarm_list.h, iotmotor_esp32_s3_sensores.ino]
2026-09-20 fix(painel): botão para recarregar a lista de alarmes da placa
    O painel só contava com a mensagem retida; o comando alarm_list existia
    no firmware e não tinha quem o enviasse, como a verificação do CI
    apontou.
2026-09-20 feat(lcd): o IP sai da primeira linha, entra a última partida
    O IP só servia para diagnóstico e já aparece na telemetria e no painel.
    Parado e conectado, a linha passa a dizer qual foi o último ensaio;
    antes de qualquer partida, "Pronto para partida".
2026-09-20 feat(lcd): contatores com hífen, "CNT 1-2"
    Com o hífen separando, um "-" sozinho para nenhum contator ficaria
    ambíguo: a linha passa a dizer "CNT nenhum".
2026-09-20 fix(web): subir o conteúdo que ficou sob o título removido
    Sem o título da seção, o espaço reservado a ele empurrava a página
    inteira para baixo.
2026-09-20 fix(web): estado das placas na mesma linha dos botões
    A faixa com o estado das duas placas ocupava uma linha só dela. Em tela
    estreita, os botões alinhados à direita saíam pela borda: nessa largura
    eles voltam a começar pela esquerda.
2026-09-20 feat(firmware,ci): mais espaco de programa e testes do app no CI
    Os dois firmwares passam a compilar com min_spiffs: 1,9 MB para a
    aplicacao, contra 1,31 MB do padrao. A ocupacao cai de 92% e 91% para
    61% nas duas placas. A tabela de particoes fica fora da area do OTA, entao
    a troca so vale depois de uma gravacao por cabo em cada placa.
    O fluxo do APK passa a rodar flutter test antes de compilar. Os testes de
    widget esperavam rotulos antigos ("Frequencia", "Vibracao", "Temperatura")
    que ja tinham sido encurtados para caber no celular; agora conferem com a
    tela. 26 testes passando.
2026-09-20 feat(seguranca): comandos cifrados no broker publico
    O broker continua sendo o test.mosquitto.org, mas cada comando passa a
    viajar cifrado e autenticado com AES-256-GCM. A chave de cada placa e
    SHA-256("iotmotor-cmd-v1" | senha | device_id), e o identificador da placa
    entra como dado autenticado: um comando selado para o quadro nao vale
    para os sensores, e mexer em um byte derruba o selo.
    Contra repeticao, a placa publica um desafio aleatorio em
    iotmotor/<placa>/auth e so aceita o comando que trouxer o desafio da vez;
    depois de aceitar, sorteia outro. Um comando gravado do ar nao vale duas
    vezes.
    A senha fica em comando_local.h (fora do Git), no navegador e no cofre do
    celular; nos firmwar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
    [comando_local.exemplo.h, comando_seguro.h, iotmotor_esp32_comandos.ino, iotmotor_esp32_s3_sensores.ino, iotmotor_mqtt_control.h]
2026-09-20 fix(ci): conferir o campo sealed onde ele e lido
    O comando_seguro.h so decifra; quem le o campo sealed sao os dois
    firmwares. A verificacao apontava para o arquivo errado.
2026-09-20 feat(app,web): nomes das placas no app e uma frase so no painel
    O app passa a chamar as placas de "Quadro de comando" e "Sensores do
    motor", como o painel: nas mensagens de comando e nos alertas, e com o
    identificador ao lado na tela de configuracoes, onde ele e necessario.
    No painel, a lista de alarmes ativos repetia a mesma frase do resumo
    quando nada estava disparado; agora a frase aparece so no resumo.
2026-09-20 feat(app): editar os alarmes da placa pelo aplicativo
    A lista que aciona o LED e o buzzer mora no ESP32-S3 e so podia ser
    editada pelo painel. Agora o app le a lista retida, mostra quais alarmes
    estao disparados segundo a telemetria e grava alteracoes na placa
    (alarm_save, alarm_remove, alarm_list), como ja fazia com as partidas.
    As grandezas oferecidas sao as mesmas do painel: vibracao e temperatura
    dos sensores, e tensao, corrente, potencia, frequencia e fator de
    potencia do quadro de comando.
2026-09-20 refactor(esp32-s3): um caminho so para os limites de alarme
    vibration_limit e temperature_limit eram espelhos de dois itens da lista,
    mantidos na telemetria e no alarm_set enquanto o painel e o app ainda
    liam os campos antigos. Agora os dois leem so a lista, e os campos saem.
    O alarm_set fica com o interruptor geral e os bipes de evento; a gravacao
    em NVS deixa de guardar um bloco de limites e guarda dois booleanos.
    [alarm_list.h, iotmotor_esp32_s3_sensores.ino]
2026-09-20 feat(esp32,web,app): hora real nas medicoes
    Nenhum dos firmwares sincronizava relogio: a telemetria so tinha sequencia
    e tempo desde o boot, entao o CSV saia com a hora de quem exportou. As
    duas placas passam a pedir a hora por NTP ao entrar na rede e a carimbar
    cada amostra no campo ts, em segundos UTC. Sem resposta do NTP, o campo
    nao aparece.
    O painel usa o carimbo no CSV (measured_at e clock_source) e o app usa no
    instante da leitura, com measuredByBoard dizendo de onde veio a hora.
2026-09-20 feat(esp32-s3,web): registro dos ultimos disparos de alarme
    Quando um alarme dispara e quando para, a placa anota o episodio: a
    grandeza, o valor no instante do disparo, a hora em UTC e a duracao. Os
    dez ultimos ficam retidos em iotmotor/esp32-02/alarm_log e aparecem no
    painel, com o mais recente em cima e o que ainda esta disparado marcado.
    O registro vive na memoria volatil: reiniciar a placa zera. Ele conta o
    que aconteceu no ensaio, nao e historico permanente.
2026-09-20 feat(web): historico que sobrevive ao fechar a aba
    Os graficos e o CSV viviam na memoria da pagina: fechou o navegador,
    perdeu o ensaio. As amostras passam a ser gravadas neste navegador, ate
    3000 ou 24 horas, e voltam ao abrir a pagina. Desconectar do broker nao
    apaga mais o que ja foi medido.
    O CSV ganha um seletor de periodo (tudo, 1 h, 24 h) e um botao para
    apagar o que esta guardado. Nada disso sai do computador: para levar um
    ensaio, exporte o CSV.
2026-09-20 docs(web): como fechar o painel com o Cloudflare Access
    O endereco e publico e o que protege a bancada e a senha de comando. Para
    fechar tambem a pagina, ficou escrito o passo a passo do Access no
    projeto Pages, com One-time PIN por e-mail.
2026-09-20 feat(web,app): a senha de comando so aparece se a placa exigir
    A bancada fica com os comandos abertos, como antes: nenhuma placa e
    gravada com senha, entao nao ha o que digitar. O campo "Senha de comando"
    some do painel e do aplicativo enquanto nenhuma placa pedir selo, e
    volta sozinho se alguma passar a pedir.
    O mecanismo continua pronto no repositorio: criar o segredo
    IOTMOTOR_CMD_SENHA e o unico passo para ligar a criptografia depois.
2026-09-20 fix(app): abrir a tela de instalacao do Android
    O app entregava o APK ao PackageInstaller e parava no aviso "Confirme a
    instalacao na tela do Android" sem que nada abrisse. Faltava receber o
    STATUS_PENDING_USER_ACTION: o sistema nao abre a confirmacao sozinho, ele
    devolve a Intent da tela para o app abrir. Sem um BroadcastReceiver
    registrado, esse aviso caia no vazio e a instalacao ficava parada.
    Agora um receptor registrado no MainActivity abre a confirmacao e devolve
    o resultado ao Flutter, que avisa se instalou ou por que nao instalou.
    No painel, a secao "Ultimos disparos" foi retirada; o registro continua
    na placa e no topico alarm_log.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
    [MainActivity.kt]
2026-09-21 feat(esp32-s3): tensao da bateria 18650 como grandeza de alarme
    A fonte UPS entrega 5 V regulados ate a celula chegar ao corte, entao a
    placa nao tinha como perceber bateria fraca: lia 5 V ate desligar de uma
    vez. Agora um divisor 100k+100k no GPIO6 leva a tensao da celula ao ADC,
    e a leitura vai para a telemetria no campo battery.
    A tensao entra na lista de alarmes como grandeza dos sensores, no painel
    e no app: da para cadastrar "Tensao da bateria abaixo de 3,4 V" e a placa
    acende o LED e apita sozinha. O painel tambem mostra a tensao junto das
    outras grandezas e a leva para o CSV.
    Sem o divisor ligado o pino fica perto de zero e o campo nao e publicado:
    nenhum alarme dispara por engano.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
2026-09-22 feat(esp32-01,web): modo instrumentacao
    Com o acionamento desligado a placa nao fecha contator nenhum: so le o
    PZEM, publica e escreve no LCD. Serve para instrumentar um motor
    acionado por comando eletrico convencional, sem o ESP32 no meio.
    O estado fica gravado na placa, sobrevive a reinicio e aparece na
    telemetria como actuation. Entrar no modo derruba as saidas ligadas na
    hora, e start passa a ser recusado com motivo claro; stop continua
    valendo sempre. No painel, um botao alterna os dois modos.
2026-09-23 fix(wifi): parar de descartar rede gravada que nao aparece na varredura
    As duas placas abriam a rede propria a cada energizacao com a rede certa
    ja gravada: era preciso entrar no portal e reconfigurar para elas
    conectarem. A causa estava em conectarEmOrdem, que pulava toda rede
    ausente da varredura feita logo apos o boot -- e essa varredura costuma
    vir incompleta, ainda mais numa rede institucional com varios pontos.
    Agora a varredura so escolhe a ordem: as vistas primeiro, as demais em
    seguida com espera menor. Em ultimo caso a placa tenta as credenciais
    que o proprio ESP32 guardou (foi o portal que gravou) e, se conectar,
    poe a rede no topo da lista, sem sobrescrever uma senha boa por vaz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
    [wifi_store.h]
2026-09-23 fix(web): placa desligada deixa de aparecer como conectada na aba Wi-Fi
    A lista de redes e retida: continua no broker depois que a placa cai. A
    aba lia so essa mensagem e escrevia "conectada em IFMA_IOT" de uma placa
    desligada havia horas.
    Agora a aba tambem assina o status de cada placa. Fora do ar, ela diz que
    a placa esta desligada ou fora da rede e que o que aparece e a ultima
    informacao recebida; os botoes que dependem da placa ficam desabilitados
    e a rede deixa de ser marcada como a atual.
2026-09-23 fix(esp32-s3): buzzer ativo deixa de apitar sem parar
    O firmware tratava o buzzer sempre como passivo (tone). Modulo ativo de
    3 pinos costuma apitar em nivel BAIXO: nesse caso, deixar o pino em LOW
    para calar fazia exatamente o contrario, e ele apitava direto, sem alarme
    nenhum disparado.
    Agora um unico lugar decide como o pino soa e como ele cala, o tipo e a
    polaridade ficam gravados na placa e sao escolhidos no painel ou pelo
    comando buzzer_set. Ao gravar, a placa silencia na hora; o boot comeca em
    silencio seja qual for o tipo, e depois do tone o pino nao fica solto.
    [iotmotor_esp32_s3_sensores.ino]
2026-09-23 feat: limite de alarme editavel e tempo de ensaio sem rede configuravel
    O campo do limite de cada alarme era redesenhado de segundo em segundo:
    apagar e digitar nao funcionava, porque o campo em que se estava
    digitando era trocado por outro novo. Agora a lista so e redesenhada
    quando algo muda de verdade, nunca com o campo em foco, o campo vazio e
    um estado legitimo (com aviso na hora de gravar) e virgula vale como
    decimal.
    O tempo que o ensaio segue sem Wi-Fi ou MQTT deixa de ser fixo em 15 s:
    da para escolher no painel entre derrubar na hora, 15 s, 1 min, 5 min ou
    sem limite. Fica gravado na placa e aparece na telemetria. Mesmo sem
    limite, o ensaio continua limitado aos 5 minutos de LIMIT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
    [iotmotor_esp32_comandos.ino, iotmotor_mqtt_control.h]
2026-09-23 revert(esp32-s3): tirar a medicao de bateria
    Sem divisor resistivo na bancada nao ha como medir a celula, entao o
    campo battery, a grandeza de alarme e a leitura no ADC saem do firmware,
    do painel e do app. O GPIO6 volta para a busca automatica do DS18B20.
    [alarm_list.h, iotmotor_esp32_s3_sensores.ino]
2026-09-23 feat(esp32-01): duracao maxima do ensaio configuravel
    O ensaio caia sempre aos 5 minutos de LIMITE_BANCADA_MS, mesmo com a
    tolerancia de rede em "sem limite". Agora o limite fica gravado na placa
    e vai de 10 s a 2 h, ou -1 para nao cair por tempo. O padrao de fabrica
    continua sendo 5 minutos.
    No painel, "Duracao maxima do ensaio" no quadro de comando, com aviso
    antes de tirar o limite. Os tempos de cada contator dentro de uma partida
    continuam presos ao teto de 5 minutos.
2026-09-23 style(web): nome IoTMotor com as cores do aplicativo
    O app escreve "IoT" em #F0B90B e "Motor" em #F4F7FB, em peso 800; a web
    escrevia tudo em branco. Agora as duas telas mostram o nome igual.
2026-09-23 feat(app): conectar por WebSocket onde as portas MQTT sao bloqueadas
    O app so falava MQTT sobre TCP. Na rede do IFMA as portas 1883, 8883 e
    8081 sao bloqueadas e so a 8080 passa -- foi por isso que as placas foram
    movidas para ws://test.mosquitto.org:8080. Sem esse caminho, o app nao
    tinha como conectar.
    O campo Broker host passa a aceitar ws:// e wss://, e a conexao usa
    WebSocket quando o endereco pede. O campo mostra a dica com o endereco
    que funciona na bancada.
2026-09-23 feat(app): a falha de conexao diz qual endereco tentar
    Quase toda falha aqui e a rede bloqueando a porta MQTT. A mensagem de
    erro passa a sugerir o caminho que funciona -- ws://host na 8080, o
    mesmo das placas -- quando o endereco e a porta apontam para isso.
2026-09-23 feat(app): diagnostico de conexao com o broker
    Quando a conexao falha na rede da escola, adivinhar porta e o que custa
    tempo. As Configuracoes ganham "Testar caminhos de conexao": o app tenta
    WebSocket 8080, WebSocket com TLS 8081, MQTT 1883 e MQTT com TLS 8883,
    mostra o que aconteceu em cada um -- bloqueio de rede, porta recusada,
    falha de TLS, nome nao resolvido -- e oferece aplicar o primeiro que
    conectar.
    Cada tentativa usa um cliente proprio e e encerrada em seguida, entao o
    teste nao mexe na conexao ativa.
2026-09-23 fix(app): mostrar por que a conexao falhou e testar sem tela parada
    O motivo da falha ia para uma linha de status fora da tela: o app so
    parecia "nao conectar". Agora, ao falhar, abre uma janela com o motivo e
    um botao para testar os caminhos.
    O teste tambem abre na hora, com os quatro caminhos em fila, e preenche
    cada um conforme responde. Antes a janela so aparecia depois de testar
    tudo -- ate 40 s olhando uma tela parada. O tempo de cada tentativa caiu
    para 6 s.
2026-09-23 fix(app): preferir IPv4 quando nao ha TLS
    Na bancada o app parou em "Network is unreachable (errno 101)" ao
    conectar. Esse erro e de rota, nao de bloqueio de porta: o nome do broker
    tem endereco IPv6, e a rede de la nao tem rota IPv6.
    Sem TLS, o app passa a resolver o nome em IPv4 e conectar direto no
    endereco -- vale para ws:// e para o MQTT em TCP. Com TLS o nome fica,
    senao o certificado nao bate. O diagnostico faz o mesmo e passa a chamar
    esse erro pelo nome, em vez de mostrar o errno.
2026-09-23 feat(web): ponte MQTT na porta 443 pela propria Cloudflare
    O painel precisa de wss:// e a rede do IFMA bloqueia a porta 8081 do
    broker publico -- em alguns computadores, em alguns dias. Agora o
    navegador abre a conexao no mesmo endereco do painel, na porta 443, e uma
    Pages Function repassa os quadros MQTT para o broker, de fora do firewall
    da escola.
    Nada e interpretado no caminho e o broker continua o mesmo das placas.
    Quem ja tinha o broker direto salvo no navegador e migrado uma vez; para
    voltar, basta digitar o endereco antigo no campo.
2026-09-23 fix(web): ponte na raiz, onde o Cloudflare Pages a procura
    A Pages Function ficou dentro de dashboard-cloudflare e nao foi
    reconhecida: /mqtt respondia com a pagina. O Pages procura a pasta
    functions na raiz do projeto.
2026-09-23 fix(web): ponte sai pela porta 8080
    A Cloudflare so faz requisicao de saida em um conjunto de portas, e a
    8081 do broker nao esta nele: a conexao subia mas nao vinha CONNACK. A
    8080 esta na lista e e a mesma porta que as placas usam.
    O trecho navegador -> Cloudflare continua cifrado na 443; o trecho
    Cloudflare -> broker vai em claro, como ja vai o das placas.
2026-09-23 fix(web): ponte fala TCP com o broker
    O repasse de WebSocket para WebSocket subia a conexao (101 com
    subprotocolo mqtt) mas nao entregava o CONNACK. Agora a ponte abre um
    socket TCP para o broker na 1883 e repassa os bytes: os quadros do MQTT
    sobre WebSocket sao os mesmos do MQTT sobre TCP, entao o repasse e byte a
    byte, na ordem, sem interpretar nada.
2026-09-23 chore(web): diagnostico da ponte MQTT
    Separa dois problemas que parecem o mesmo no navegador: a Cloudflare nao
    chegar no broker e a ponte nao repassar os bytes. Abre o socket, manda um
    CONNECT e mostra o que voltou.
2026-09-23 fix(web): ponte espera o socket abrir e avisa a falha
    A escrita para o broker acontecia antes de o socket TCP estar aberto e o
    erro era engolido: a conexao ficava de pe sem nunca entregar o CONNACK.
    Agora a ponte espera socket.opened e, se algo falhar, fecha o WebSocket
    com o motivo -- que aparece do lado de quem tentou conectar.
2026-09-23 fix(web): ponte converte o quadro do WebSocket corretamente
    Os quadros chegam como ArrayBuffer, como view ou como Blob, dependendo de
    quem esta do outro lado. A conversao so cobria o primeiro caso e os
    outros viravam zero byte: a conexao ficava de pe, o CONNECT sumia e o
    painel esperava um CONNACK que nunca vinha.
2026-09-23 fix(lcd): nome da partida vai sem acento para o display
    O HD44780 nao entende UTF-8: cada acento valia dois bytes e saia como
    dois simbolos estranhos, empurrando o resto da linha para fora das 20
    colunas. O nome e transliterado so na ida para o LCD; no painel, no app e
    na telemetria continua com acento.
    De quebra, o limite do nome: a placa guarda 24 bytes e cada acento ocupa
    dois, mas o painel e o app contavam 24 caracteres -- um nome acentuado
    perto do limite era recusado sem explicacao. Agora os dois contam bytes e
    dizem quanto falta.
    A transliteracao foi conferida com um teste compilado a parte, extraindo
    a funcao do proprio sketch.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
    [iotmotor_esp32_comandos.ino]
2026-09-24 feat(esp32-s3): polaridade do LED ajustavel pelo painel
    Modulo de catodo comum acende em nivel alto; de anodo comum, em nivel
    baixo. Com a polaridade trocada o LED fica apagado justamente quando
    deveria acender, e parece que nao funciona. A escolha era uma constante
    de compilacao: agora fica gravada na placa e muda pelo painel ou pelo
    comando led_set.
    Ao gravar, a placa acende as tres cores por 1,5 s com a regra nova, para
    conferir na hora.
2026-09-24 Revert "feat(esp32-s3): polaridade do LED ajustavel pelo painel"
    This reverts commit 9ba0794f34974f2f3d5a3109886ca7870cdd95a3.
    [iotmotor_esp32_s3_sensores.ino]
2026-09-24 fix(esp32-s3): buzzer ativo travava a placa em ciclo de reinicio
    Com o buzzer configurado como ativo, soar() chamava soar(false) dentro do
    proprio ramo de buzzer ativo: a condicao nunca mudava e a recursao nao
    tinha fim. A pilha estourava na primeira chamada e a placa reiniciava.
    O efeito so aparecia depois que a configuracao era lida da NVS -- o
    soar(false) do setup() roda antes disso, com buzzerAtivo ainda falso --,
    entao a placa bootava normal e morria no bipe de conexao ao broker,
    menos de um segundo depois de conectar. Como ela nunca ficava no ar,
    nem o comando de atualizacao alcancava mais a placa.
    Serial da bancada: 13 ciclos identicos de boot -> Wi-Fi -> broker ->
    "Guru Meditation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
    [iotmotor_esp32_s3_sensores.ino]
2026-09-24 fix(esp32-s3): entrar na rede gravada sem passar pelo portal
    Duas causas de a placa oferecer a rede propria a cada religada, ambas no
    arranque frio:
    O radio ficava com a economia de energia ligada, o padrao do core. O
    quadro de comando desliga isso desde o firmware original (setSleep(false))
    e e a placa que nunca cai na mesma rede; o S3 nunca teve a chamada. Com o
    radio dormindo entre os beacons, a varredura sai incompleta e a associacao
    demora mais.
    E o setup() dava dez segundos para entrar na rede antes de abrir o portal.
    Uma passada pela lista leva menos de meio minuto, entao dez segundos nem
    davam para tentar as duas redes gravadas. Agora insiste ate noventa
    segundos; o portal continua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
    [iotmotor_esp32_s3_sensores.ino]
2026-09-25 fix(s3/wifi): reconectar direto no ponto de acesso e canal da ultima rede
    A placa S3 demorava para entrar numa rede que ja conhecia porque cada
    WiFi.begin fazia varredura de todos os canais antes de associar, e a
    espera de 5 s na rede preferida as vezes cortava a conexao no meio,
    jogando a placa na varredura completa e nas demais redes.
    Agora o BSSID e o canal da ultima conexao boa ficam gravados na NVS e a
    primeira tentativa vai direto nesse ponto de acesso, sem varredura. Se
    o AP sumiu ou recusou a senha, a espera acaba na hora e a mesma rede e
    tentada com varredura, agora com ate 8 s. O log mostra quanto tempo a
    conexao levou.
    Clau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
    [wifi_store.h]
2026-09-25 revert(s3/wifi): voltar a conexao Wi-Fi do S3 ao estado de 22/09
    A pedido, a conexao Wi-Fi do ESP32-S3 volta a ser exatamente a de 22/09,
    antes das correcoes de Wi-Fi feitas nele: wifi_store.h e o trecho de
    Wi-Fi do setup()/loop() ficam iguais aos do commit 6b2b40e. Desfaz
    24c3026 (so na pasta do S3), 6532952, 3572bb1 e 73a80d6. O restante do
    firmware (alarmes, buzzer, etc.) nao muda.
    Claude-Session: https://claude.ai/code/session_01PcK61kbMxj7fr1XwYs8v1Z
    [iotmotor_esp32_s3_sensores.ino, wifi_store.h]
2026-09-25 fix(s3/wifi): reaplicar a correcao de nao descartar rede fora da varredura
    Reaplica no S3 somente a correcao do 24c3026: a varredura do boot so
    define a ordem das tentativas e nao descarta mais uma rede gravada que
    nao apareceu nela; em ultimo caso, tenta as credenciais guardadas pelo
    driver do ESP32. O wifi_store.h volta a ser identico ao do esp32-01. O
    restante do Wi-Fi do S3 continua como em 22/09.
    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
    [wifi_store.h]
2026-09-25 revert(esp32-s3): buzzer volta ao comportamento de 22/09
    Desfaz 6bc1e9f e e3aa353: o buzzer volta a ser sempre passivo, acionado
    por tone()/noTone() no pino 42, como em 22/09. Sai a escolha de tipo e
    polaridade (comando buzzer_set, seletor "Tipo do buzzer" no painel e o
    campo buzzer da telemetria). O 6bc1e9f so corrigia um bug do e3aa353,
    por isso sai junto. LED nao muda.
    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
    [iotmotor_esp32_s3_sensores.ino]
2026-09-25 ESP32-S3: sempre emitir 2 bipes ao conectar ao MQTT
2026-09-25 Painel: adicionar botão para procurar buzzer
2026-09-25 Painel: adicionar testes individuais do LED RGB
2026-09-25 ESP32-S3: adicionar teste individual das cores do LED
2026-09-25 Painel: adicionar procura dos canais do LED
2026-09-25 Painel: enviar comando led_probe
2026-09-25 ESP32-S3: adicionar varredura dos canais do LED RGB
2026-09-25 Painel: adicionar log de diagnostico GPIO
2026-09-25 Painel: exibir sequencia de respostas dos probes
2026-09-25 ESP32-S3: ampliar probes de LED e buzzer para GPIO4 e GPIO15
    [iotmotor_esp32_s3_sensores.ino]
2026-09-25 ESP32-S3: adicionar teste fisico sequencial RGB e buzzer
    [iotmotor_esp32_s3_sensores.ino]
2026-09-25 Painel: exibir ACKs divergentes e erros de comando seguro
2026-09-25 ESP32-S3: restaurar firmware anterior aos testes de diagnostico
2026-09-25 Painel: remover controles temporarios de diagnostico de LED
2026-09-25 Painel: remover diagnosticos temporarios de LED e hardware
2026-09-25 Painel: adicionar ajuste de frequencia do buzzer
2026-09-25 ESP32-S3: tornar frequencia do buzzer configuravel e persistente
    [iotmotor_esp32_s3_sensores.ino]
2026-09-25 Painel: impedir telemetria antiga de sobrescrever frequencia do buzzer
2026-09-25 Painel: usar frequencia do slider no teste de LED e buzzer
2026-09-25 ESP32-S3: testar LED e buzzer na frequencia escolhida no painel
    [iotmotor_esp32_s3_sensores.ino]
2026-09-25 Painel: adicionar botao Testar LED
2026-09-25 Painel: enviar comando de teste sequencial do LED
2026-09-25 ESP32-S3: adicionar teste sequencial das tres cores do LED
2026-09-25 ESP32-S3: teste de LED silencioso com 1 segundo por cor
2026-09-25 ESP32-S3: implementar estados do LED conforme conexao e motor
2026-09-25 ESP32-S3: corrigir deteccao de motor ligado pela partida ativa
    [iotmotor_esp32_s3_sensores.ino]
2026-09-25 Wi-Fi: reduzir demora para alcancar redes disponiveis
2026-09-25 Reverter ajuste de conexao Wi-Fi no ESP32-01
    [wifi_store.h]
2026-09-25 Testes: atualizar alarmes para buzzer ajustavel e LED
2026-09-25 Testes: alinhar indicador ao limite de telemetria de 6 segundos
2026-09-25 S3: restaurar wifi_store compartilhado sem alterar ESP32-01
2026-09-25 ESP32-S3: priorizar IFMA_IOT sem alterar logica do ESP32-01
2026-09-25 ESP32-S3: evitar bloqueio no portal Wi-Fi durante o boot
2026-09-25 ESP32-S3: robustecer recuperacao Wi-Fi apos quedas
2026-09-26 Painel: mostrar clientes de comando ativos no diagnostico
2026-09-26 Painel: identificar clientes de comando app e web
2026-09-26 App: anunciar presenca como cliente de comando MQTT
2026-09-26 Adiciona animação compacta do motor ao diagnóstico
2026-09-26 Liga animação do diagnóstico ao estado real do motor
2026-09-26 Corrige estado do motor usando relés na telemetria
2026-09-26 Testa estado do motor derivado dos contatores
2026-09-26 Remove atualização de firmware do quadro de comando
2026-09-26 Substitui motor do diagnóstico por SVG semi-realista
2026-09-26 Refina animação do motor em operação
2026-09-26 Remove simulação de vibração mecânica do motor
2026-09-26 Mantém apenas a animação de rotação do motor
2026-09-26 Adiciona ventoinha traseira animada ao motor SVG
2026-09-26 Ajusta ventoinha traseira para perspectiva lateral embutida
2026-09-26 Corrige eixo de rotação da ventoinha traseira
2026-09-26 Corrige ventoinha com animação SVG e restaura efeito de rotação do eixo
2026-09-26 Aciona animação SVG da ventoinha conforme estado do motor
2026-09-26 Restaura efeito visual de rotação no eixo do motor
2026-09-26 Restaura SVG estável do motor após efeito visual inesperado
2026-09-26 Adiciona efeito discreto de rotação na ponta do eixo
2026-09-26 Animate motor cooling fan rotation
2026-09-26 Add motor sound test control
2026-09-26 Add synthesized induction motor sound test
2026-09-26 Increase motor sound test volume
2026-09-26 Move motor sound controls to settings
2026-09-26 Integrate configurable motor sound with live state
2026-09-26 Calibrate motor sound volume range
2026-09-26 Polish motor sound settings toggle UI
2026-09-26 Sync motor sound enabled status label
2026-09-26 Make motor fan rotation visibly animated
2026-09-26 Drive motor fan rotation with SVG animation loop
2026-09-26 Confine animation to rear motor fan blades
2026-09-26 Rotate fan blades around local SVG center
2026-09-26 Restore previous motor animation visuals
2026-09-26 Restore previous motor fan animation behavior
2026-09-26 Fix rear fan spin: drop CSS transform-origin conflicting with SVG rotate
    The CSS transform-origin on .motor-fan and .motor-fan-perspective was
    applied on top of the transform attributes, so rotate(a 118 240) made the
    fan orbit out of the SVG instead of spinning in place.
    Claude-Session: https://claude.ai/code/session_01Ecaab8b85CX52JK9trsx9R
2026-09-26 Fix rear fan spin: drop CSS transform-origin conflicting with SVG rotate (#5)
    The CSS transform-origin on .motor-fan and .motor-fan-perspective was applied on top of the transform attributes, so rotate(a 118 240) made the fan orbit out of the SVG instead of spinning in place.
    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
2026-09-26 Keep rear fan animation inside its housing
    The amber rotation marker sat at the blade tips, beyond the fan opening,
    so it orbited over the rim like a loose part. The five blades were also
    different shapes at uneven angles, making the spin look lopsided.
    Use one blade shape repeated every 72 degrees and move the marker onto
    a blade near the hub.
    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
2026-09-26 Make motor sound resemble a real induction motor
    Replace the three pure tones with a model of a 4-pole motor on a 60 Hz
    grid: a harmonic-rich 120 Hz magnetic hum with inrush on start, rotor
    rumble and unbalance at ~29 Hz, pink-noise cooling-fan air pulsing at
    the 5-blade pass frequency, and faint bearing hiss. Mechanical parts
    spin up over ~1.8 s and coast down after power-off while the hum cuts
    out immediately. Mix level keeps peaks below full scale at 100% volume.
    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
2026-09-26 Cut rotor modulation together with the hum on power-off
    rotorMod fed humGain.gain directly, so zeroing humGain's baseline left
    the rotor oscillator modulating the hum during coast-down. Route the hum
    through a separate power gain after the modulation and cut that instead.
    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
2026-09-26 Silence a coasting motor sound before starting a new one
    When the 5 s test ended while automatic sound was on and the motor was
    running, the test graph kept coasting for ~3.5 s while startAutomatic()
    built a second graph, so both played at once. Keep the coasting graph
    reachable and cut it quickly whenever a new sound starts or another
    stop begins.
    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
2026-09-26 Ventoinha contida no aro e som de motor mais realista (#6)
    - Rear fan: five identical blades every 72 degrees and the amber marker moved onto a blade near the hub, so nothing orbits over the rim.
    - Motor sound: model of a 4-pole induction motor on 60 Hz (120 Hz harmonic hum with inrush, rotor rumble, fan air at blade-pass rate, bearing hiss), spin-up and coast-down, hum cut on power-off.
    - A coasting sound is silenced before a new one starts, so the end of the 5 s test no longer overlaps the automatic sound.
    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
2026-09-26 ESP32-S3: retry DS18B20 detection instead of only at boot
    The sensor board searched for the DS18B20 once in setup(). If it did not
    answer then (loose wire, missing 4k7 pull-up), temperature stayed missing
    until a reboot, while the MPU already had a periodic retry. Rescan every
    30 s while no sensor is found, quietly after the first warning, and skip
    the scan while the buzzer probe may be driving candidate pins.
    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
    [iotmotor_esp32_s3_sensores.ino]
2026-09-26 ESP32-S3: nova procura do DS18B20 quando não encontrado no boot (#7)
    The sensor board searched for the DS18B20 only once in setup(). If it did not answer then (loose wire, missing 4k7 pull-up), temperature stayed missing until a reboot. Rescan every 30 s while no sensor is found, quietly after the first warning, and skip the scan while the buzzer probe may be driving candidate pins.
    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
    [iotmotor_esp32_s3_sensores.ino]
2026-09-26 Motor diagram: heat tint, alarm cues and gradual spin-up/coast-down
    - Body tints from amber to red as the DS18B20 reading approaches the
    temperature alarm limit (lowest enabled 'above' limit, 60 C default);
    a grey '?' marks sensor data without a temperature reading.
    - Firing alarms pulse the diagram outline red and show a thermometer on
    the body (temperature) or waves at the feet (vibration). Alarm ids map
    to fields through the retained alarm list, now exposed read-only by
    alarm-controls.js, falling back to the board's default ids.
    - Fan, rotor and shaft spin up over 1.8 s and coast down on stop, in
    step with the motor sound, instead of starting and stopping at once.
    Honors pre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
2026-09-26 Coast the motor diagram down on the same curve as the sound
    An exponential decay with tau 1.2 s kept the fan, rotor and shaft
    turning for ~6.6 s after power-off while the sound stops in 3.4 s. Use
    motor-sound.js's easeCoast over COAST_S scaled by the current speed, so
    both reach zero together.
    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
2026-09-26 Advance motor spin-up/coast on real elapsed time
    Clamping the whole frame interval to 64 ms also froze the start/stop
    transition while the tab was hidden, so returning showed a motor still
    spinning (or barely started) long after the state changed. Use the real
    elapsed time for the transition and keep the cap only for the angle step.
    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
2026-09-26 Motor do painel: cor pela temperatura, alarmes e partida/parada graduais (#8)
    - Body tints amber to red as temperature approaches the alarm limit; grey '?' when sensors report no temperature.
    - Firing alarms pulse the outline red with a thermometer (temperature) or waves at the feet (vibration).
    - Fan, rotor and shaft spin up in 1.8 s and coast down on the same curve as the motor sound, on real elapsed time.
    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
2026-09-26 Alarm panel: tell sensor failure apart from a crossed limit
    The sensor board raises alarm_active when a sensor has no reading, not
    only when a limit is crossed, so a missing DS18B20 showed 'ALARME:
    limite ultrapassado' with nothing in the active list. Keep mpu_ok and
    temperature_ok from telemetry, label that case 'ALARME: falha de
    sensor', and list each sensor without a reading under active alarms.
    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
2026-09-26 Motor card: corner flag for unread or high readings instead of '?'
    Drop the grey '?' from the motor drawing. Instead, a flag in the corner
    of the drawing counts warnings (amber, red once a limit is crossed) and
    a list under the readings names them: sensor board or command board
    without data, temperature/vibration without a reading, PZEM without
    measurements, and values at 90% of an enabled alarm limit or beyond
    (board defaults until the alarm list arrives).
    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
2026-09-26 Motor warnings: match firmware alarm rules
    - Compare limits strictly (> / <) like alarm_list.h, so a reading equal
    to the limit is a near-limit warning, not an alarm the board never
    raises.
    - With several alarms on the same field and direction, keep the most
    severe result instead of the first one listed.
    - Skip limit warnings while alarm monitoring is off on the board;
    missing-reading warnings stay.
    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
2026-09-26 Motor card: drop the corner flag, keep only the warning list
    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
2026-09-26 Painel: avisos de leitura/limite no card do motor e alarme por falha de sensor (#9)
    - Motor card lists warnings under the readings: boards without data, temperature/vibration/PZEM without a reading, and values at 90% of an enabled alarm limit or beyond (strict comparison like the firmware, most severe alarm per field, none while monitoring is off). The '?' on the drawing is gone.
    - Alarm panel tells a sensor failure apart from a crossed limit and lists sensors without a reading under active alarms.
    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
2026-09-26 Single warning list: move motor card warnings into 'Alarmes ativos'
    The card's warning list repeated what 'Alarmes ativos' already showed.
    The motor card is visual only again (drawing plus readings line), and
    'Alarmes ativos' also lists the dashboard warnings it lacked: values at
    90% of a limit ('atenção'), command board without data and readings
    missing without a listed sensor failure ('sem leitura'). Crossed limits
    still come only from the board's alarms_firing.
    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
2026-09-26 Painel: uma única lista de alarmes e avisos (#10)
    The motor card is visual only again; 'Alarmes ativos' is the single written list: board alarms (disparado), sensor failures (falha) and dashboard warnings it lacked - near-limit values (atenção), command board without data and readings missing without a listed failure (sem leitura). Crossed limits still come only from alarms_firing.
    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
2026-09-26 Motor card: drop the inner frame and draw the motor larger
    The drawing sat in its own bordered box inside the card. Remove that
    frame so the motor sits directly on the card, move the alarm outline to
    the card border, and widen the drawing column from 142 px to 210 px
    (about 45% larger); stacked on narrow screens it scales up to 320 px.
    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
2026-09-26 Card do motor sem quadro interno e com o motor maior (#11)
    Remove the inner frame around the drawing, move the blinking alarm outline to the card border, and widen the drawing column from 142 px to 210 px (up to 320 px when stacked on narrow screens).
    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
2026-09-26 Motor card: drop the status badge that repeated the title
    'Motor ligado' next to 'EM OPERAÇÃO' (and the same for stopped, waiting
    and offline) said the same thing twice. Keep only the title, which is
    more specific, and move the badge's colored status dot in front of it.
    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
2026-09-26 Card do motor: título com bolinha de estado, sem selo repetido (#12)
    Drop the status badge that repeated the title ('Motor ligado' + 'EM OPERAÇÃO' etc.) and move its colored state dot in front of the title.
    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
2026-09-26 Remote restart for the sensor board
    Add a 'restart' command to the ESP32-S3 firmware (ack, then
    ESP.restart()) and a 'Reiniciar placa' button in the Wi-Fi tab, shown
    only for the sensor board: that board only measures, while restarting
    the command board would drop the contactors.
    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
2026-09-26 Restart: defer to loop() and support the command board too
    - Calling mqtt.loop() from the command callback re-enters PubSubClient
    (the sketch already warns about it). Publish the ack, flag the restart
    and let loop() call ESP.restart() 300 ms later instead.
    - The command board also accepts 'restart', refused while any output or
    start sequence is on (same guard as update/wifi_portal), and dropped if
    an output turns on before it fires.
    - The 'Reiniciar placa' button now works for both boards, with a warning
    about the contactor guard for the command board.
    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
2026-09-26 Reinício remoto das placas (#13)
    - Both firmwares accept a 'restart' command: ack first, then loop() calls ESP.restart() 300 ms later (no mqtt.loop() re-entry from the command callback).
    - The command board refuses while any output or start sequence is on, and drops a pending restart if an output turns on.
    - 'Reiniciar placa' button in the dashboard Wi-Fi tab for both boards.
    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
2026-09-26 Motor sound: play a real motor recording instead of pure synthesis
    Add motor-ligado.mp3 (the recording provided by the user) and loop its
    steady part (0.6-3.55 s, skipping the switch clicks) with a 0.25 s
    equal-power crossfade so the seam does not click. Start and stop speed
    the recording up and down (pitch and level together) on the same
    curves as the fan animation. The synthesized sound stays as a fallback
    if the file cannot load, now with less electrical hum and hiss.
    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
2026-09-26 Motor sound: keep the recording's switch clicks as on/off cues
    The clicks in the recording mark the motor being switched on and off,
    so use the file as recorded: start from its beginning (switch-on click)
    and loop the steady part (1.0-3.55 s, the loop end blended into the
    audio just before the loop start so the wrap is seamless); on stop,
    play the switch-off clicks and run-down from 3.70 s to the end. The
    clicks are soft-limited so they stay loud but do not clip. The
    artificial pitch ramps are no longer used with the recording.
    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
2026-09-26 Motor sound: only the latest start request proceeds after loading
    Automatic start and the sound test both await the recording load. A
    request token makes a start that was overtaken while waiting (e.g. the
    user started the test) give up instead of stopping the newer sound.
    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
2026-09-26 Add clear visual click feedback to dashboard buttons
2026-09-26 Add reusable button click feedback
2026-09-26 Soften dashboard button click feedback
2026-09-26 Make button click feedback ultra subtle
2026-09-26 Trigger motor sounds only from control commands
2026-09-26 Tie motor audio to successful start and stop button commands
2026-09-26 Make button press feedback barely perceptible
2026-09-26 Stop motor audio silently when dashboard disconnects
2026-09-26 Resume steady motor audio after reconnect
2026-09-26 Restore motor audio when reconnect confirms motor running
2026-09-26 Restore steady motor audio after reopening dashboard
2026-09-26 Make button press feedback slightly more noticeable
2026-09-26 Motor sound: a second test click while loading cancels the test
    With the recording still loading, both clicks awaited the same promise;
    the first started the test and the second returned, so the user could
    not cancel. Remember the pending test request and let the next click
    cancel it.
    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
2026-09-26 Motor nameplate data, run-hour meter/starts and command feedback
    Command board (ESP32-01):
    - New iotmotor_motor_info.h: optional nameplate data (kW, V, A, rpm,
    service factor) stored in flash, published retained on 'motor_info'
    and set with 'motor_info_set'.
    - Run-hour meter and start counters (total and today, Brasilia date)
    kept on the board and saved on each start/stop and every 10 min
    running; telemetry gains run_s_total, starts_total, starts_today and
    session_s. 'motor_counters_reset' zeroes them, only with outputs off.
    In instrumentation mode the motor counts as running above 0.3 A.
    Dashboard:
    - 'Dados do motor' section in Configurações (motor-info.js) reads and
    writes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
2026-09-26 Motor data: power in cv, single/three-phase, no field examples
    Store the nameplate power in cv (power_cv) instead of kW, add the motor
    type (phases: 1 single-phase, 3 three-phase, optional) on the board and
    in the 'Dados do motor' form, and drop the example placeholders.
    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
2026-09-26 Motor nameplate data, run-hour meter/starts and command feedback (#15)
    * Motor sound: a second test click while loading cancels the test
    * Motor nameplate data, run-hour meter/starts and command feedback
    service factor) stored in flash, published re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
2026-09-26 Dashboard: explain 'unknown_action' refusals as a firmware update hint
    A board on older firmware answers new commands with 'unknown_action',
    which the dashboard showed raw. Translate it (iotmotorSelo.motivo) into
    a message telling the user to update the board with the motor stopped,
    in every place that shows a command refusal.
    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
2026-09-26 Dashboard: explain 'unknown_action' refusals as a firmware update hint (#16)
    service factor) stored in flash, publis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
2026-09-26 Dashboard: firmware update badge and overload alarm from motor data
    Firmware version (Wi-Fi tab):
    - Read firmware_version from each board's retained 'capabilities' topic
    and compare it with FIRMWARE_PUBLICADO, the version built from main
    into the firmware-latest OTA release. The tab and the board selector
    get an amber dot and the update button is highlighted when a board
    differs; CI checks FIRMWARE_PUBLICADO against both .ino files.
    Overload alarm (Configurações):
    - With a nominal current in 'Dados do motor', suggest the overload limit
    (nominal current x service factor, or the nominal alone without one)
    and offer to create the current alarm or adjust the existing one.
    Co-Auth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
2026-09-26 Dashboard: firmware update badge and overload alarm from motor data (#17)
    service factor) stored in flash, published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
2026-09-26 Motor data: three-phase dual voltage (delta/star) and connection in use
    A three-phase nameplate carries two voltages and two currents
    (e.g. 220/380 V - 12,6/7,3 A). The 'Dados do motor' voltage and current
    fields now take one value or two separated by a slash (delta first), and
    a 'Ligação em uso' select (Triângulo/Estrela, default Triângulo, as in
    star-delta starting) appears when two are given.
    Command board (firmware v13-dupla-tensao) stores voltage_y_v,
    current_y_a and connection, validating that the star pair has the
    higher voltage and lower current and that only three-phase motors take
    two voltages. The dashboard load and the overload alarm suggestion use
    the current of the connect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
2026-09-26 Motor data: three-phase dual voltage (delta/star) and connection in use (#18)
    service factor) stored in flash, publi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
2026-09-26 Voltage/starts alarm suggestions, maintenance reminder, ISO 10816 vibration
    - Alarm suggestions from the motor data now also cover low/high voltage
    (-/+10% of the voltage of the connection in use) and too many starts
    per hour (6, created only), next to the overload one.
    - Command board (v14-manutencao) publishes starts_hour (starts in the
    last 60 min); the sensors board (s3-sensors-1.5-partidas) accepts
    alarms on it; the dashboard offers it as an alarm quantity.
    - Maintenance reminder: 'Manutenção a cada (h de uso)' in the motor
    data, a 'Manutenção feita' button (maintenance_done, stores the hour
    meter and date on the board), status in the motor data section and the
    usage l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
    [alarm_list.h, iotmotor_esp32_comandos.ino, iotmotor_esp32_s3_sensores.ino, iotmotor_motor_info.h, iotmotor_mqtt_control.h]
2026-09-26 Hourly history kept on the sensors board, with a 7-day chart
    The dashboard only recorded while open. The sensors board
    (s3-sensors-1.6-historico) now keeps, for each hour of the last 7 days,
    the mean/max current and mean voltage (from the command board
    telemetry), mean/max temperature, mean/max vibration and minutes the
    motor ran. Current and vibration only count while the motor runs.
    Each day is stored in NVS (history.h, 388 bytes) when its hour closes
    and published retained on <prefix>/<sensors>/history/<0..6>; the MQTT
    buffer grows to 2048 bytes to fit a day.
    The dashboard gets a 'Histórico da placa · últimos 7 dias' panel
    (board-history.js): pick current, temperature, vibration, volt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
    [historico.h, iotmotor_esp32_s3_sensores.ino]
2026-09-26 Normalize decimal motor data from ESP32 float values
2026-09-26 Publish rounded motor plate decimal values
2026-09-26 Test normalization of ESP32 float artifacts
2026-09-26 App: motor data, usage, maintenance, firmware notice and board history
    The app now matches the dashboard for the new motor features:
    - Subscribes to motor_info, capabilities and history/+ (retained).
    - models/motor_info.dart: nameplate data with the current/voltage of the
    connection in use, hour meter and starts from the command board
    telemetry, maintenance status, ISO 10816 vibration estimate, firmware
    situation (firmwarePublicado, checked in CI against the dashboard and
    both .ino files) and the board history parser.
    - Início: a strip under the start controls with load %, vibration zone,
    hour meter/starts, maintenance due soon/overdue and boards needing a
    firmware update.
    - His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
2026-09-26 Fix review findings: per-device state, instrumentation running, reset guard
    - Command board publishes motor_running (the hour meter's own rule, so
    it covers instrumentation mode, where the motor runs with no relay);
    the sensors board uses it for the hourly history instead of the
    profile/phase heuristic, falling back to it for older command boards.
    - motor_counters_reset is also refused while the hour meter sees the
    motor running (instrumentation mode).
    - The sensors board read command telemetry only up to 900 bytes and
    parsed it twice into a 1 KB document; with the hour meter fields the
    telemetry is close to that. It now parses it once on the heap (up to
    1800 bytes) and hands t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
    [alarm_list.h, iotmotor_esp32_comandos.ino, iotmotor_esp32_s3_sensores.ino, iotmotor_mqtt_control.h]
2026-09-26 Motor alarms from nameplate, maintenance reminder, ISO 10816 vibration, board history and app parity (#19)
    service f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
    [alarm_list.h, historico.h, iotmotor_esp32_comandos.ino, iotmotor_esp32_s3_sensores.ino, iotmotor_motor_info.h, iotmotor_mqtt_control.h]
2026-09-26 Track OTA until firmware version is confirmed
2026-09-26 Allow independent firmware updates per device
2026-09-26 Test concurrent OTA commands for both boards
2026-09-26 Align motor maintenance actions on one row
2026-09-26 Remove duplicate motor alarm suggestions block
2026-09-26 Remove motor alarm suggestion logic
2026-09-26 Remove obsolete motor alarm suggestion tests
2026-09-26 Sync motor sound from confirmed telemetry state
2026-09-26 Drive motor audio from command telemetry
2026-09-26 Remove command-origin motor audio trigger
2026-09-26 Add app commands for motor nameplate and maintenance
2026-09-26 Add motor data and maintenance controls to Android app
2026-09-26 Fix Flutter motor settings UI compatibility
2026-09-26 Test motor settings tab in app
2026-09-26 Match per-device OTA completion message
2026-09-26 Repair motor settings editor and number formatting
2026-09-27 README: friendlier GitHub page with screenshots and diagram
    - New README: logo, CI badges, quick links (painel, APK, firmware),
    dashboard screenshots, feature table, a Mermaid diagram of the boards,
    broker, dashboard and app, hardware table, getting started, repository
    layout and a bench-safety note.
    - The previous app/MQTT notes move to docs/app-mqtt.md.
    - docs/images: dashboard, history, motor data and phone screenshots, plus
    a 1280x640 social preview for the repository settings.
    - History chart: skip the last day label when it would be cut at the
    right edge.
    Claude-Session: https://claude.ai/code/session_01Ecaab8b85CX52JK9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
2026-09-27 README: friendlier GitHub page with screenshots and diagram (#20)
    service factor) stored in flash, published retaine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
2026-09-27 Expose start profile type for motor animation
2026-09-27 Feed motor animation with RPM profile and vibration
2026-09-27 Add realistic telemetry-driven motor animation v2
2026-09-27 Refine motor motion blur heat and reduced-motion styling
2026-09-27 Test start profile telemetry for motor animation
2026-09-27 Test motor animation v2 behavior
2026-09-27 Validate motor animation v2 in web checks
2026-09-27 Remove motor vibration displacement effect
2026-09-27 Remove motor vibration transform styling
2026-09-27 Remove motor vibration animation test
2026-09-27 Add native animated motor card to Flutter app
2026-09-27 Fix numeric typing in Flutter motor animation
2026-09-27 Show animated motor above start controls in app
2026-09-27 Test native motor animation card in app
2026-09-27 Harden Flutter motor animation numeric types
2026-09-27 Docs: user guide, MQTT reference, hardware, firmware and development
    New docs/ set, in Portuguese, written from the current code:
    - guia-de-uso.md: connecting, the Painel screen, starting the motor and
    the start editor, test safety, measurement-only mode, motor data and
    dual voltage, maintenance, board alarms, history, the Dispositivos tab
    (firmware, restart, Wi-Fi), command password, the Android app and a
    troubleshooting table, with screenshots.
    - mqtt.md: broker paths, every topic, telemetry fields of both boards,
    retained messages (motor_info, profiles, alarms, alarm_log, history,
    wifi, auth), how to send a command, every action per board, sealed
    commands and refusal reasons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
2026-09-27 Compact app motor animation card
2026-09-27 Update compact motor animation test
2026-09-27 Add persistent motor sound service to app
2026-09-27 Provide motor sound service across app
2026-09-27 Let Riverpod own motor sound service lifecycle
2026-09-27 Harden app motor sound looping and playback errors
2026-09-27 Sync app motor sound with confirmed motor state
2026-09-27 Expose motor sound test state to settings
2026-09-27 Add motor sound controls to app settings
2026-09-27 Fix motor sound volume typing
2026-09-27 Test motor sound controls in app settings
2026-09-27 Bundle motor sound inside Android app
2026-09-27 Bundle motor audio asset in app
2026-09-27 Crossfade local motor audio for seamless loop
2026-09-27 Docs: user guide, MQTT reference, hardware, firmware and development (#21)
    service factor) stored in flash, publishe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
2026-09-27 App: seamless motor sound loop, same as the web dashboard
    The app looped the recording by switching between two MediaPlayers every
    2.15 s, driven by position callbacks that arrive about every 200 ms and
    an MP3 source; the late, uneven switch and the second player's start-up
    delay made a dip that sounded like the sound restarting.
    The recording is now pre-rendered into three WAVs with the dashboard's
    own processing (makeSampleParts, run in Chromium by
    tools/gerar-audio-motor.js): the start, the steady loop with its seam
    already blended, and the stop. The loop plays in SoundPool
    (PlayerMode.lowLatency, ReleaseMode.loop), which repeats it from memory
    sample by sample. On start the loop fades i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
2026-09-27 App: desenho do motor com proporções naturais
    O desenho era longo e baixo (340x165, carcaça 2,3:1 e eixo comprido) e
    parecia esticado na horizontal. Novo desenho em 304x172, com tampas mais
    redondas, eixo mais curto e área de desenho maior. O texto de estado
    passa a quebrar em vez de estourar em tela estreita.
    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
2026-09-27 App: carga e avisos dentro do cartão do motor
    A faixa de uso (carga, vibração, horímetro, manutenção e firmware) saía
    num painel próprio entre o comando e os gráficos. Agora fica dentro do
    cartão do motor: ao lado do estado em tela larga e numa linha embaixo do
    desenho no celular. Sobra mais altura para os gráficos.
    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
2026-09-27 App: som contínuo, motor proporcional e carga dentro do cartão (#22)
    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
2026-09-27 App: versão 2.0 (#23)
    Muda a versão do app no pubspec de 1.0.2 para 2.0.0.
2026-09-27 Firmware: partida sem bloqueio de rede, 6 partidas, alarme sem rede
    Quadro de comando (v15-partida-sem-bloqueio):
    - Reconectar o Wi-Fi (varredura e tentativas, ate ~30 s) e o MQTT (ate
    12 s) bloqueava o loop; com o Wi-Fi ou o broker fora, a troca
    estrela-triangulo e os tempos da partida ficavam parados. Enquanto ha
    contator para ligar ou desligar (trocaPendente), essas tentativas
    esperam; o ESP32 segue voltando a ultima rede sozinho.
    - A lista de partidas em 2048 bytes transbordava com seis partidas de
    nome longo: a sexta era gravada sem os contatores e sumia no boot.
    Documento de 3 KB (conferido com ArduinoJson 6.21.5 em 32 bits) e
    buffer MQTT de 2 KB para publicar a lista int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
    [comando_seguro.h, iotmotor_esp32_comandos.ino, iotmotor_esp32_s3_sensores.ino, iotmotor_motor_info.h, iotmotor_mqtt_control.h, iotmotor_profiles.h]
2026-09-27 Painel: uma conexao MQTT, instrumentacao, CSV da ultima hora, MQTT.js local
    - mqtt-shared.js trocava mqtt.connect, que no MQTT.js 5 e so leitura: a
    pagina lancava erro ao carregar e cada modulo abria o proprio
    WebSocket (7 por aba, medido no Chromium). Agora substitui window.mqtt
    por um objeto com as mesmas funcoes; 1 WebSocket. Teste com a
    biblioteca de verdade.
    - MQTT.js 5.10.4 servido pelo proprio painel (vendor/, do pacote npm):
    sem script de terceiros, CSP com script-src 'self'.
    - motor_running conta como motor ligado: no modo instrumentacao o motor,
    a carga, a vibracao ISO 10816 e o som aparecem com o motor girando.
    - Registros no navegador com so as colunas do CSV: a ultim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
2026-09-27 App: broker das placas por padrao, sem servico de fundo, instrumentacao
    - Instalacao nova comecava em broker.hivemq.com:1883, onde nao ha placa:
    conectava e nunca chegava dado. Padrao agora e ws://test.mosquitto.org
    na 8080 (o caminho que passa na rede do IFMA). O clientId fixo
    "motor_app" fazia dois celulares se derrubarem no broker: cada
    instalacao ganha um id unico. Perfis antigos migram so se ainda
    estiverem no padrao intocado.
    - Removido o servico em segundo plano: abria uma segunda conexao MQTT
    (que nem conectava com ws:// ou wss://), repassava mensagens que nada
    lia e mantinha notificacao fixa e bateria, enquanto o app dizia
    "monitoramento em segundo plano ativo". Saem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
2026-09-27 Revisao: Desligar sempre aberto, NTP sem broker, APK de PR sem segredos
    - Desligar sai sempre aberto (painel e app): com senha errada o selo era
    cifrado, a placa nao abria e recusava antes de ver que era parar. Com
    selo possivel, sai tambem selado, para placas antigas com senha.
    - S3: relogio::manter roda assim que ha Wi-Fi, antes do retorno do MQTT;
    ligando sem broker, a hora nunca sincronizava e o historico offline
    descartava tudo.
    - android-apk.yml: PR sem os segredos (fork, Dependabot) testa e compila
    com a chave de debug, sem conferir a assinatura; push na main continua
    exigindo a chave de publicacao.
    Claude-Session: h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
    [iotmotor_esp32_s3_sensores.ino]
2026-09-27 Checkup geral: correções no firmware, painel e app (#24)
    Firmware v15-partida-sem-bloqueio e s3-sensors-1.7-offline: reconexão sem travar a partida, 6 partidas em 3 KB, Desligar sempre aceito, senha mínima, alarme e histórico sem rede.
    Painel: uma conexão MQTT (eram 7), MQTT.js local, modo instrumentação, CSV da última hora, aviso de intertravamento.
    App: broker e clientId corretos por padrão, sem serviço de fundo, modo instrumentação, fontes embutidas, analyze limpo.
    CI: firmware e APK compilam na PR; APK só ARM.
    [comando_seguro.h, iotmotor_esp32_comandos.ino, iotmotor_esp32_s3_sensores.ino, iotmotor_motor_info.h, iotmotor_mqtt_control.h, iotmotor_profiles.h]
2026-09-27 Mute motor sound while app is in background
2026-09-27 Sync motor audio with app foreground lifecycle
2026-09-27 Enforce foreground-only motor audio in sound service
2026-09-27 Stop motor animation immediately on MQTT disconnect
2026-09-27 Test disconnected motor animation state
2026-09-27 App: alertas no celular, com opcao de ativacao
    Em Configuracoes > Alertas no celular (desligado por padrao), o app avisa
    quando um alarme da placa dispara, mesmo fechado.
    - alertas_da_bancada.dart: logica pura, com testes. Segue alarms_firing da
    placa de sensores (os mesmos alarmes do LED e do buzzer) e a lista
    retida em alarms. Alarme que dispara: notificacao com som, com o limite
    e a leitura atual ("Temperatura acima de 60 C - agora 65,3 C"). Ao
    voltar ao normal, a mesma notificacao vira "Normalizado", sem som.
    Alarme oscilando no limite toca no maximo uma vez a cada 5 min. Com o
    monitoramento da placa desligado, o celular fica quieto.
    - alertas_no_celular.dart: servico Androi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
2026-09-27 App: alertas no celular, com opção de ativação (#25)
    Configurações › Alertas no celular (desligado por padrão): serviço Android em primeiro plano (specialUse) com conexão MQTT própria avisa quando um alarme da placa dispara, mesmo com o app fechado; notificação com som ao disparar, "Normalizado" sem som ao voltar, no máximo um som a cada 5 min por alarme. Volta após reiniciar o celular; desligado, sai do boot.
2026-09-27 App: eixos dos graficos sem rotulos quebrados
    Os rotulos do eixo vertical saiam com duas casas (231.60) numa largura
    fixa de 48 px: o texto quebrava em duas linhas e o "0" de sobra cobria
    o rotulo de baixo ("@31.6" e um "0" solto no celular). Agora as casas
    seguem o intervalo (0,2 -> uma casa), a largura do eixo segue o maior
    rotulo e o texto nao quebra. A escala usa uns 4 intervalos em vez de 6,
    e o eixo das amostras mostra so os multiplos do intervalo (o 63 colava
    no 60).
    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
2026-09-27 App: painel de partida mais baixo
    O seletor de partida tinha 74 px de altura, com o rotulo "Partida do
    motor" flutuando sobre a borda, e o botao ficava numa faixa com rolagem
    horizontal (no celular o Ligar saia cortado). Agora seletor e botao tem
    46 px, o rotulo "Partida" fica dentro do seletor e o seletor ocupa a
    largura (ate 340 px): o painel perde ~32 px de altura, que sobram para os
    graficos, e o botao cabe inteiro.
    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
2026-09-27 App 2.1.0: versoes com nome e release por versao
    Cada atualizacao do app passa a ter numero e nome: version do
    pubspec.yaml e nomeDaVersao em lib/app/versao.dart. Esta e a 2.1.0,
    "Alertas no celular" (primeira com os alertas, os graficos corrigidos e
    o painel de partida menor).
    - android-apk.yml: na PR que muda o app, exige versao maior que a da
    main; na main, publica tambem a release app-v<versao> com o titulo
    "IoTMotor 2.1.0 — Alertas no celular" e o APK, e o app-latest.json leva
    o nome.
    - App: Configuracoes mostra "App: versao 2.1.0 — Alertas no celular", e a
    verificacao de atualizacao mostra numero e nome da publicada e da
    instalada.
    - docs/desenvolvimento.md explica a reg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
2026-09-27 App 2.1.0 "Alertas no celular": versões com nome, gráficos e painel de partida (#26)
    Versões do app com número (pubspec) e nome (lib/app/versao.dart); o CI exige versão maior na PR e publica a release app-v<versão> com o nome. Eixos dos gráficos sem rótulos quebrados e painel de partida mais baixo.
2026-09-27 Desarme automatico por alarme (opcional), app 2.2.0
    Cada alarme da placa de sensores pode, alem de avisar, desligar o motor.
    A opcao e por alarme e vem desligada (campo "trip").
    - Placa de sensores (s3-sensors-1.8-desarme): alarme com desarme
    disparado, com o quadro acionando o motor (relays ou partida), manda
    ao quadro {"action":"stop","reason":"alarm","alarm","field"}; repete a
    cada 3 s enquanto disparado. Nao age com o monitoramento desligado.
    O episodio no alarm_log sai com "trip":true. Documento da lista em
    2 KB (oito alarmes com o campo novo).
    - Quadro (v16-desarme): guarda qual alarme desligou o motor e publica
    trip_alarm/trip_field ate a proxima partida; o LCD mostra
    "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
2026-09-27 Lista de alarmes redesenha ao mudar o desarme; registro de alarmes com folga
    - Painel: a assinatura da lista inclui trip, senao marcar/desmarcar
    'desliga o motor' em outra aba nao atualizava a caixa.
    - S3: publishAlarmLog usa documento de 3 KB e nao publica se estourar
    (10 eventos com trip passavam de 1,5 KB).
    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
2026-09-27 Desarme automático por alarme (opcional) — app 2.2.0 (#27)
    service factor) stored in flash, published retained on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
2026-09-27 Vibração em mm/s RMS (ISO 10816-3), app 2.3.0
    A vibração passa a seguir o padrão de máquinas elétricas: velocidade RMS
    em mm/s, medida pela placa em vez de estimada.
    - Placa de sensores (s3-sensors-1.9-mms): MPU a 1000 amostras/s pela FIFO
    (I2C a 400 kHz), passa-altas de 8 Hz, integral e outro passa-altas
    (-3 dB em 10 Hz), RMS por eixo em janelas de 1 s; vale o pior eixo.
    Nova telemetria vibration_mms e vibration_axis; o g continua.
    - Alarme vibration_mms; o de fábrica vira 4,5 mm/s, e o antigo (pico
    0,5 g, nunca editado) é migrado na atualização.
    - Histórico da placa em centésimos de mm/s, com "vib" dizendo a unidade;
    dias antigos em g continuam legíveis e ficam for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
    [alarm_list.h, historico.h, iotmotor_esp32_s3_sensores.ino, vibracao.h]
2026-09-27 Vibração em mm/s RMS (ISO 10816-3) — app 2.3.0 (#28)
    service factor) stored in flash, published retained on 'mot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
2026-09-27 Só vibração em mm/s: aceleração em g sai de tudo, app 2.3.1
    Em motores se mede vibração (velocidade RMS, ISO 10816-3); a aceleração
    em g não é mais calculada, publicada, mostrada nem usada em alarmes.
    - Placa de sensores (s3-sensors-1.10-vibracao): sem vibration e
    vibration_peak na telemetria; alarmes antigos em g viram vibration_mms
    de 4,5 mm/s, mantendo ligado/desligado e desarme.
    - Painel: sem gráfico de aceleração, sem grandezas em g nos alarmes, sem
    a estimativa de mm/s pela rotação; "Vibração sem leitura" só olha mm/s.
    - App: sem accelerationG, sem a estimativa, sem alarmes e coluna de CSV em g.
    - App 2.3.1 "Só vibração"; guia e documentação MQTT atualiza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
    [alarm_list.h, iotmotor_esp32_s3_sensores.ino, vibracao.h]
2026-09-27 Simuladores publicam vibration_mms em mm/s
    Os simuladores de desenvolvimento ainda mandavam só 'vibration' (g), que o
    app e o painel não leem mais.
    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
2026-09-27 Só vibração em mm/s: aceleração em g sai de tudo — app 2.3.1 (#29)
    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
2026-09-27 feat(firmware): configuracao sincronizada de aquisicao no ESP32-01
2026-09-27 feat(firmware): comandos MQTT para configuracao de aquisicao
2026-09-27 feat(firmware): sincroniza taxa MQTT do ESP32-S3
2026-09-27 feat(web): expõe comando genérico autenticado para configurações
2026-09-27 feat(web): sincroniza intervalos de grafico e registro
2026-09-27 feat(web): painel técnico de aquisição e registro
2026-09-27 feat(app): modelo de configuracao sincronizada de aquisicao
2026-09-27 feat(app): adiciona topico de configuracao de aquisicao
2026-09-27 feat(app): aplica configuracao sincronizada de aquisicao
2026-09-27 feat(app): tela de aquisicao sincronizada com web e firmware
2026-09-27 chore(app): sobe versao para 2.4.0
2026-09-27 chore(app): nomeia versao de aquisicao sincronizada
2026-09-27 fix(web): carrega configuracao de aquisicao ao conectar
2026-09-27 test(web): valida buckets exatos e media dos graficos
2026-09-27 fix(app): usa buckets exatos e media por janela nos graficos
2026-09-27 test(app): valida buckets temporais exatos nos graficos
2026-09-27 chore(app): sobe versao para 2.4.1
2026-09-27 chore(app): nomeia versao de graficos sincronizados
2026-09-27 fix(app): remove RMS da vibração no cartão do motor
2026-09-27 chore(app): sobe versao para 2.4.2
2026-09-27 chore(app): nomeia versao de animacao compacta
2026-09-27 fix(web): remove RMS da vibração no cartão do motor
2026-09-27 fix(web): desloca motor à esquerda e amplia espaço das métricas
2026-09-27 fix(web): dá mais folga ao motor no cartão de diagnóstico
2026-09-27 chore(app): sobe versao para 2.4.3
2026-09-27 fix(web): afasta textos do eixo do motor
2026-09-27 docs(dev): atualiza versão e checklist de aquisição
2026-09-27 docs: adiciona esquema da cadeia de processamento da vibração
2026-09-27 docs: adiciona esquema de montagem do sensor no motor
2026-09-27 docs: adiciona linha do tempo das cadências de aquisição
2026-09-27 docs: adiciona gráfico esquemático da faixa de vibração
2026-09-27 docs: adiciona metodologia completa de vibração em mm/s
2026-09-27 docs: destaca metodologia de vibração no README
2026-09-27 docs: adiciona guia técnico de vibração ao índice
2026-09-27 docs(hardware): integra montagem e metodologia de vibração
2026-09-27 docs(firmware): referencia processamento de vibração
2026-09-27 docs(mqtt): qualifica campos de vibração e validade
2026-09-27 docs(dev): adiciona manutenção da documentação de vibração
2026-09-27 docs: registra origem e processamento do áudio do motor
2026-09-27 docs: adiciona aviso de origem do áudio de terceiros
2026-09-27 docs: integra documentação do áudio do motor
2026-09-27 feat(app): adiciona tópico de presença dos clientes
2026-09-27 feat(app): assina presença de clientes App e Web
2026-09-27 feat(app): mostra dispositivos e clientes na barra de status
2026-09-27 feat(app): adiciona resumo de dispositivos e clientes na conexão
2026-09-27 ui(web): simplifica rótulo de clientes
2026-09-27 chore(app): sobe versão para 2.4.4+13
2026-09-27 chore(app): nomeia versão de dispositivos e clientes
2026-09-27 docs: explica contagem de dispositivos e clientes
2026-09-27 test(app): cobre contagem de clientes App e Web
2026-09-27 Adiciona projetos Proteus
    Adiciona projetos Proteus da placa sensor e da placa de comando.
    [Case.pdsprj, Shield_V3.pdsprj]
2026-09-27 feat(motor): animação do motor mais leve e igual no app e no painel web
    App (Flutter):
    - Ticker dorme com o motor parado e sem alarme: antes o cartão inteiro era
    reconstruído ~60 vezes por segundo, mesmo desligado ou desconectado.
    - Só o desenho é repintado a cada quadro (ValueNotifier + RepaintBoundary),
    sem refazer textos, faixa de uso e o desfoque do GlassPanel.
    - Desenho portado do SVG do painel web: ventoinha em perspectiva, caixa de
    ligação, tampa com parafusos, rotor e eixo solidários.
    - Movimento em motor_motion.dart com os mesmos números do motor-animation.js:
    parada por inércia exponencial, borrão das pás, religar durante a parada
    sem voltar ao zero.
    - Aqueci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
2026-09-27 chore(app): sobe versão para 2.5.0+14 (Motor animado mais leve)
    Claude-Session: https://claude.ai/code/session_0189GDF6aG8NRjVo5XnGhWMc
2026-09-27 fix(motor): alarme do cartão só com telemetria recente e para qualquer grandeza
    - liveFiringAlarmIds: a lista alarms_firing vale por 6 s (TELEMETRY_STALE_MS
    do web) e só com o broker conectado; o cartão reavalia a cada segundo
    enquanto há alarme, então um alarme antigo some e o ticker volta a dormir.
    - Alarmes de corrente, tensão, potência etc. acendem o cartão como 'other'
    no web; só temperatura e vibração têm ícone piscando no desenho.
    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
2026-09-27 test(configurações): espera leitura e gravação em vez de atrasos fixos
    O teste 'broker digitado vence o perfil MQTT' falhava no CI: o dispose()
    grava as configurações sem esperar, e o controlador seguinte lia o arquivo
    antes de a gravação terminar (ou no meio dela).
    - MotorControlController.ready: termina quando o que estava salvo foi lido.
    - settingsWritten: termina quando a última gravação chegou ao disco; as
    gravações passam a ir em fila, sem duas escrevendo o arquivo ao mesmo tempo.
    - Os testes de persistência esperam por esses futures em vez de 150/300 ms.
    Reproduzido com 400 ms de atraso na gravação: o teste antigo falha com o
    mesmo erro do CI e o novo passa.
    Co-Au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
2026-09-27 fix(firmware): OTA confere o certificado do GitHub e loop() ganha watchdog
    OTA (ota_update.h, as duas placas):
    - Troca setInsecure() pelos certificados raiz da Mozilla que já vêm
    compilados no mbedTLS do core (CONFIG_MBEDTLS_CERTIFICATE_BUNDLE_DEFAULT_FULL).
    Numa rede com DNS ou Wi-Fi falso o download é recusado em vez de gravar
    outro programa; vale para qualquer autoridade que o GitHub use.
    - A data dos certificados não é conferida (MBEDTLS_HAVE_TIME_DATE desligado):
    placa sem hora do NTP atualiza igual.
    Watchdog (watchdog.h, novo, as duas placas):
    - loop() inscrito no vigia de tarefas com 60 s; travou, a placa reinicia e as
    saídas voltam ao repouso no boot. Antes, um loop(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
    [iotmotor_esp32_comandos.ino, iotmotor_esp32_s3_sensores.ino, ota_update.h, watchdog.h, wifi_portal.h, wifi_store.h]
2026-09-27 refactor(app): divide o controller e a aba Configurações por assunto
    Sem mudança de comportamento: os mesmos 78 testes passam e as sete abas das
    Configurações renderizam pixel a pixel iguais às da main (a única diferença é
    o clientId sorteado a cada abertura, que também muda entre duas rodadas da
    própria main).
    - motor_control_controller.dart: 3.273 -> 1.536 linhas. Os métodos saem para
    partes da mesma biblioteca (part/extension), então continuam enxergando os
    campos privados e quem usa o controller não muda nada:
    motor_control_alerts, _history, _start_types, _boards e _devices.
    - settings_tab.dart: 2.740 -> 1.175 linhas. Motor, Perfis, Alertas e a seção
    de manutenç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
2026-09-27 chore: atualiza dependências, API obsoleta e actions para Node 24
    - flutter pub upgrade dentro das restrições atuais (39 pacotes, entre eles
    mqtt_client 10.8 -> 10.11 e path_provider_android 2.3). As versões novas
    grandes (Riverpod 3, fl_chart 1.x, flutter_secure_storage 11,
    package_info_plus 10, google_fonts 8, flutter_lints 6) ficam para uma PR
    própria; cryptography segue fixo em 2.7.0.
    - DropdownButtonFormField: value (obsoleto) -> initialValue. Teste novo
    garante que o perfil de aquisição acompanha a configuração vinda da placa.
    - Workflows: checkout@v5, setup-node@v5, setup-java@v5 e upload-artifact@v6
    (Node 24). arduino/setup-arduino-cli@v2 ainda não tem versão e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
2026-09-27 fix(app): Atualizar firmware e Cadastrar Wi-Fi chegam às placas
    Os dois botões publicavam em iotmotor/auto/command: a conexão do app usa
    sempre o dispositivo "auto", e cada placa só escuta o próprio tópico. O app
    dizia "Pedido enviado" e nada acontecia.
    - Atualizar firmware (botão único, como antes) vai para cada placa no ar com
    firmware diferente do publicado, no tópico dela. Fica desabilitado quando
    todas estão em dia.
    - Cadastrar Wi-Fi (botão único) pergunta no próprio diálogo qual placa abre a
    rede, porque ela sai do ar por 3 minutos.
    - "No ar" segue o painel web: status retido diferente de "offline".
    - O serviço recusa publicar comando em "auto", para o erro não v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
2026-09-27 fix(app): manutenção só para placas online agora, conferidas na hora de enviar
    - maintenanceBoards exige o status retido 'online' (a placa publica ao
    conectar; o broker troca por 'offline' quando ela cai). Placa conhecida
    só pelo histórico ou de outra conexão não recebe comando.
    - sendMaintenanceCommand confere a lista de novo antes de publicar: placa
    que caiu ou terminou de atualizar com o diálogo aberto fica de fora e
    aparece na mensagem.
    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
2026-09-27 feat(ota): retorna sequência dos comandos de manutenção
2026-09-27 ui(app): mostra ESP em atualização em vez de desconectado
2026-09-27 chore(app): sobe versão para 2.5.3+17
2026-09-27 fix(web): prioriza OTA no status do quadro e sensores
2026-09-27 ui(app): explica quando não há firmware para atualizar
2026-09-27 chore(app): sobe versão para 2.5.4+18
2026-09-27 test(web): bloqueia atualização de firmware em dia
2026-09-27 ui(app): mantém botão de firmware sempre clicável
2026-09-27 Mirror web maintenance messages beside firmware button
2026-09-27 Handle board restart status without misleading online question
2026-09-27 Test restart feedback and reconnection flow
2026-09-28 App: abas Histórico, Alertas e Configurações com visual de aplicativo
    - Casca: barra inferior NavigationBar lisa, cabeçalho com estado da conexão,
    sem vidro, faixa de notícias nem animações de entrada fora do Início.
    - Configurações viram uma lista agrupada que abre telas próprias (Conexão,
    Placas e atualizações, Motor, Notificações, Aquisição, Armazenamento).
    Perfis entram na Conexão, campos técnicos ficam em "Avançado", limites do
    app ficam recolhidos em Notificações e a aba Telemetria sai.
    - Histórico: filtros em grade 2x2, exportar/limpar no menu da seção, eventos
    como lista simples (ícone, título, placa e hora), gráfico de 7 dias só
    aparece qua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
2026-09-28 App: conta todas as placas no ar e valida "Avançado" recolhido
    - O cabeçalho usa connectedDeviceCount (tráfego recente sem "offline"),
    não só as placas com status retido "online".
    - "Avançado" mantém os campos montados ao recolher, para o Form validar
    Client ID e prefixo; a mensagem de erro aponta para "Avançado".
    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
2026-09-28 App: configurações voltam a usar abas no topo
    As seções (Conexão, Placas, Motor, Notificações, Aquisição, Armazenamento)
    ficam em abas roláveis no topo da tela, no lugar da lista que abria telas
    separadas. A aba Placas mostra um ponto laranja quando há firmware novo.
    O conteúdo de cada seção não muda.
    Versão 2.5.6+20 "Abas nas configurações".
    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
2026-09-28 App: faixa de informações no topo, ícones nas abas e histórico sem repetição
    - Topo: volta a faixa que corre com conexão, placas no ar, leituras,
    alertas e quem está usando (app/web). Não reinicia a cada mudança de
    texto e fica parada quando cabe na largura.
    - Configurações: abas com ícone e nome; o ponto de firmware novo fica no
    ícone de Placas.
    - Histórico: mostra só mudanças do motor (ligou, desligou com o tempo que
    ficou ligado, troca de modo). Leituras repetidas e o eco da segunda placa
    não viram evento. Filtros reduzidos a Placa (com nome) e Período; o CSV
    continua exportando todas as leituras.
    - Versão 2.5.7+21 "Histórico só com mudanças".
    Co-Author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
2026-09-28 App: eventos do quadro de comando, gravação das mudanças e faixa parada
    - O quadro de comando não manda motor_on: a leitura passa a contar o motor
    como ligado pelos contatores (relays) ou, sem eles, pelo motor_running,
    como a tela ao vivo. Sem isso o histórico dependia da placa de sensores.
    - A gravação guarda toda leitura em que o motor ligou, desligou ou trocou
    de modo, além do ritmo de registro; antes um liga/desliga entre dois
    registros sumia ao reabrir o app.
    - A faixa do topo só anima quando o texto não cabe; parada, não pede
    quadros.
    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
2026-09-28 S3: bipe do painel toca com o motor parado (#55)
    atualizarSinalizacao zerava a fila de bipes nos ramos 'sem rede' e
    'motor parado', e so chamava atualizarBeeps com o motor ligado e normal.
    Com o motor parado (caso da bancada), o Testar bipe era aceito mas nao
    tocava. Agora os dois ramos avancam a fila de bipes.
    Claude-Session: https://claude.ai/code/session_015VAzrEikyuoZRQCFEtAHmo
2026-09-28 S3: firmware s3-sensors-1.12-ota-seguro (bipe com motor parado)
    Sobe a versao do firmware dos sensores para o painel e o app oferecerem a
    atualizacao OTA com a correcao do bipe (#55). Mesma versao no .ino, no
    FIRMWARE_PUBLICADO do painel e no firmwarePublicado do app.
    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
2026-09-28 fix(ota): aumenta timeout e robustece redirects do GitHub
    [ota_update.h]
2026-09-28 fix(ota): sincroniza rotina robusta no ESP32-S3
    [ota_update.h]
2026-09-28 dashboard: aponta para firmwares OTA robustos
2026-09-28 web: adiciona proxy direto para firmware OTA
2026-09-28 fix(ota): usa proxy Cloudflare com fallback GitHub
    [ota_update.h]
2026-09-28 fix(ota): sincroniza proxy Cloudflare no S3
    [ota_update.h]
2026-09-28 firmware: quadro v20 e S3 1.15 com lista Wi-Fi preservada
    - wifi_store: nos boots seguintes preserva a lista do usuario e so
    acrescenta redes novas de wifi_local.h (quadro e S3).
    - S3 sobe para s3-sensors-1.15-ota-cloudflare para o painel e o app
    oferecerem a atualizacao OTA.
    - painel e app: mudancas de controle remoto, perda de conexao e telas.
    - ci: regex do firmwarePublicado aceita a lista formatada em varias
    linhas pelo dart format e roda remote-controls.test.cjs.
2026-09-29 fix(quadro): proteção sem rede, reinício remoto e resposta do OTA (v21) (#56)
    - Queda de rede: a proteção que desliga as saídas roda antes das reconexões de Wi-Fi/MQTT; com saídas ligadas, reconexão bloqueante só se nenhuma proteção vencer durante a espera.
    - Reinício remoto: diferença com sinal, a placa espera os 300 ms para a resposta sair.
    - OTA: resposta de falha usa cópia do seq; buffer da resposta de 256 para 384 bytes.
    - Quadro v21-ota-cloudflare (firmware, painel e app); app 2.5.8.
    Claude-Session: https://claude.ai/code/session_01PYjtir7ZV16QbR2Js2QVsd
    [iotmotor_esp32_comandos.ino, iotmotor_mqtt_control.h]
2026-09-29 fix(mqtt): usa WebSocket seguro via Cloudflare
    [mqtt_websocket_client.h]
2026-09-29 fix(mqtt): sincroniza WebSocket seguro no S3
    [mqtt_websocket_client.h]
2026-09-29 fix(quadro): MQTT via Cloudflare 443 e publica v22
    [iotmotor_esp32_comandos.ino]
2026-09-29 fix(s3): MQTT via Cloudflare 443 e publica 1.16
    [iotmotor_esp32_s3_sensores.ino]
2026-09-29 fix(quadro): ajusta janela de reconexao MQTT TLS
    [iotmotor_esp32_comandos.ino]
2026-09-29 Improve Wi-Fi reconnection on both ESP32 boards
2026-09-30 Show ESP32 health diagnostics
2026-09-30 Add automatic ESP32 health assessment
2026-09-30 Publish Wi-Fi diagnostics periodically on both ESP32 boards
    Both boards now republish the Wi-Fi/health diagnostics every 30 s while
    connected to MQTT, so the panel's health assessment stays current instead
    of only updating on reconnect. Bumps firmware to v26-mqtt-cloudflare and
    s3-sensors-1.20-mqtt-cloudflare.
2026-09-30 Polish dashboard readability and refresh doc screenshots
    - Decimal comma in every on-screen number (cards, motor summary, chart axes,
    alarm warnings); CSV export keeps the dot.
    - Last reading shown as age ("há 3 s"), red once it is stale.
    - Disabled buttons use a neutral style instead of a faded action colour.
    - Export CSV / Limpar move from the top bar to the real-time charts card.
    - Contactor chips wrap instead of overflowing on medium widths.
    - Empty feedback boxes collapse.
    - New tools/capturar-telas.mjs renders docs/images from the dashboard with an
    in-page fake broker; all screenshots regenerated for v26 / s3-1.20.
2026-09-30 Add OTA rollback, native firmware tests and gated firmware publishing
    The boards have no cable access, so a bad OTA must heal itself:
    - ota_update.h defers the image confirmation (verifyRollbackLater) until the
    board subscribes to its command topic. A build that crashes, boot-loops or
    never reaches MQTT is rolled back by the bootloader on the next boot.
    Verified in the ELF that initArduino calls the sketch's hook.
    - The panel reports when a board comes back from an update with the old
    version instead of waiting for a timeout.
    - Firmware v27-mqtt-cloudflare / s3-sensors-1.21-mqtt-cloudflare.
    Native tests (esp32/testes_nativos, g++ against a fake Arduino, real headers):
    - start profil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
    [iotmotor_esp32_comandos.ino, iotmotor_esp32_s3_sensores.ino, ota_update.h, teste.h, teste_alarmes.cpp]
2026-09-30 Split the app controller and the two largest tabs into parts
    Behaviour-preserving move, following the existing part/extension layout:
    - MotorControlController (1630 -> 645 lines): connection and commands,
    settings, and incoming telemetry move to motor_control_connection.dart,
    motor_control_settings.dart and motor_control_telemetry.dart.
    - InicioTab (1231 -> 304): start panel and charts in inicio_partida.dart and
    inicio_graficos.dart.
    - ConfiguracoesTab (1023 -> 314): connection, acquisition and storage pages
    in settings_conexao/aquisicao/armazenamento.dart.
    setState is protected, so the extensions go through a one-line _atualizar.
    flutter analyze reports the same notices as before; a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
2026-09-30 Motor card: bigger drawing, grey idle dot and vibration tremor
    - The drawing sits above the text on every screen size, not only on phones,
    so it is no longer squeezed next to three lines of text.
    - The title dot is grey when the motor is stopped; green only when running.
    - The motor trembles when the ISO vibration zone is Alerta (0.8 px) or
    Crítica (1.8 px). The value was already on data-vib-zone but unused.
    Off with prefers-reduced-motion.
    - Numbers and units no longer break across lines (non-breaking space).
    - capturar-telas.mjs closes the browser through DevTools: on Windows,
    killing only the parent left dozens of Edge processes behind.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
2026-09-30 Dashboard: choose motor drawing effects in settings
    Configurações › "Animação e som do motor" now has, next to the existing
    sound switch, one checkbox per effect: rotation, vibration tremor,
    temperature colour and alarm blinking. All on by default; saved per
    browser. Each disabled effect sets data-anim-*="off" on the motor card and
    CSS turns it off; with rotation off the animation loop sleeps. Verified in
    headless Edge, including after a reload.
2026-09-30 App: choose motor drawing effects in settings, add vibration tremor
    Configurações › Motor gets an "Animação do motor" section with switches
    for rotation, vibration tremor, temperature colour and alarm blinking, saved
    on the phone (SharedPreferences) like the motor sound. The app and the web
    dashboard keep independent choices.
    The drawing now trembles in the Alerta (0.8 px) and Crítica (1.8 px) ISO
    zones, using the same vibration source as the zone label on the card.
    With rotation off the motor is drawn settled and the ticker only runs for
    blinking or tremor. The system "reduce motion" still overrides everything.
    App 2.6.0 ("Escolha dos efeitos da animação do motor"); 102 tests pas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
2026-09-30 Sensors: integrate vibration with Al-Alaoui instead of the trapezoid
    The trapezoidal integrator at 1 kHz under-read high frequencies (-4.8 % at
    120 Hz, -7.5 % at 150 Hz, -10.9 % at 180 Hz). The Al-Alaoui integrator
    (7/8 current + 1/8 previous sample) costs the same and stays within 1.3 %
    up to 180 Hz. Native tests now require 2 % at 30, 120, 150 and 180 Hz and
    1 % at 60 Hz. vibracao.md documents both methods and the error table.
    Firmware s3-sensors-1.22-mqtt-cloudflare; app 2.6.1 announces it.
    [iotmotor_esp32_s3_sensores.ino, teste_vibracao.cpp, vibracao.h]
2026-09-30 Read the published firmware version at runtime instead of hardcoding it
    Every firmware bump used to force an app release: the app only offers
    "Atualizar firmware" for boards whose version differs from the list
    compiled into it, so an old app thought new firmware was "em dia".
    - publish-firmware.yml extracts firmware_version from each .ino and uploads
    firmware-latest.json to the firmware-latest release.
    - The /firmware/ Cloudflare function also serves that file (the browser
    cannot read GitHub release assets because of CORS).
    - The dashboard fetches it on load; the app on every broker connection
    (Cloudflare first, GitHub as fallback). The hardcoded lists remain only
    as an offline fall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
2026-09-30 Motor info: add the remaining nameplate fields
    Store, publish and edit nominal frequency, power factor, efficiency and
    IE class, duty, insulation class, max ambient temperature, temperature
    rise, IP rating, manufacturer, model and serial number. All optional.
    The firmware validates and persists them and grows the motor_info and
    command JSON buffers to fit; the dashboard and the app read and edit
    the same fields. Docs and tests updated.
2026-09-30 Command board: running needs a closed contactor and current
    With actuation on, a closed relay alone no longer counts as the motor
    running: the measured current must also be above 0.3 A, so a relay with
    no motor attached neither spins the drawing nor adds to the hour meter
    and start count. Without a PZEM reading, the contactor alone still
    counts. A current drop shorter than 3 s with the contactor closed (the
    star-delta dead time) is not a stop, so it does not add a second start.
    [iotmotor_esp32_comandos.ino]
2026-09-30 Dashboard: motor readings beside the drawing, one per line
2026-09-30 Command board: bump firmware to v28
    Publishes the nameplate fields and the running rule (closed contactor
    and current) as a new version, so the dashboard and the app offer the
    OTA update.
2026-09-30 Dashboard: motor data buttons on one row below the fields
    "Gravar no quadro" landed in whatever grid cell was left after the
    fields, and the other two buttons sat in a separate row under the form.
    The three buttons now share one row at the end of the form, and the
    fields use equal-width columns.
2026-09-30 Dashboard: training CSV with both boards per row and a condition label
    The exported CSV is now shaped for fault detection and classification:
    - One row per instant with the command board and the motor sensors; a
    reading from the other board joins the row if it arrived within 3 s.
    - Context columns: motor_running, mode, profile, session_s, relay_1 to
    relay_4, pzem_ok, mpu_ok, temperature_ok, vibration samples and axis.
    - A "Condição" field labels the rows recorded from then on (column
    condition).
    - A 10 % slack on the record interval, so 1 s publishing no longer
    drops about half of the 1 s rows.
    Rows stored in the old per-board format are discarded on first load.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
2026-09-30 Add a continuous CSV collector and share the test condition over MQTT
    tools/coletor/coletor.py subscribes to both boards' telemetry and writes
    one CSV per day with exactly the dashboard's training columns, without
    a browser open and without the one-hour limit. It follows the
    dashboard's record interval, reconnects on its own and logs data gaps.
    A test runs the dashboard's JavaScript in Node and checks both produce
    the same CSV lines.
    The dashboard publishes the "Condição" field to the retained topic
    iotmotor/system/condition, so the collector labels its rows too. Text
    typed while disconnected is published on connect and is not replaced
    by the older retained value.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
2026-09-30 Sensors: per-axis vibration features and velocity spectrum (s3 1.23)
    Each 1 s window now also publishes, per axis, a "vib" object for fault
    detection and classification:
    - velocity RMS, acceleration RMS and peak, crest factor and kurtosis;
    - a 1024-point Hann FFT of the velocity, summarized as RMS in 17 bands
    of 10 Hz centred on 20..180 Hz (edges clear of 60/120 Hz and 1x/2x
    running speed) and the dominant peak (interpolated Hz and mm/s).
    vibration_mms is unchanged, so alarms, history and the app keep working.
    The telemetry document and payload move to static buffers; native tests
    check known sines and the worst-case message size (1220 bytes payload,
    1802 of 3072 document bytes on the E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
    [iotmotor_esp32_s3_sensores.ino, teste_vibracao.cpp, vibracao.h, vibracao_json.h]
2026-09-30 Dashboard and collector: vibration diagnostics columns in the CSV
    Both read the sensors' "vib" object and add 72 columns (vib_x_mms ..
    vib_z_b180): 7 statistics and 17 spectrum bands per axis. The
    collector-vs-dashboard test now covers vibration data too.
2026-10-01 Board history: legend that matches what the chart shows
    The 7-day board history legend was a fixed sentence. It now lists only
    what is drawn for the chosen quantity, each with a swatch in its colour:
    average line (noting "with the motor running" for current and
    vibration), hourly maximum, isolated-hour dots, or on-time bars. Notes
    appear only when they apply: zero current logged as running (command
    board before v28), empty stretches, and, on the web dashboard, old days
    whose vibration was in g.
    Same logic in the dashboard (legendaDoHistorico) and the app, with
    tests in both. App 2.6.2.
2026-10-02 Reordena conteúdo dos cards de grandezas
2026-10-02 Aumenta destaque dos valores nos cards de medições
2026-10-02 Sobe app para 2.6.4
2026-10-02 Destaca valor na base dos cards de medições
2026-10-02 Reduz números e altura dos cards para painel compacto no app 2.6.7
2026-10-02 Corrige largura inicial do gráfico de histórico
2026-10-02 Transforma marcadores dos gráficos em balões tipo pin
2026-10-02 Corrige leitura UTF-8 do manifesto de atualização
2026-10-02 Aproveita melhor a largura nas linhas de informação
2026-10-02 Sobe app para 2.6.10
2026-10-02 Testa estado visual de partida bloqueada
2026-10-02 Mostra bloqueio de partida por falta de medição no painel web
2026-10-02 Testa motivo visual de partida bloqueada na web
2026-10-02 Versão 2.6.11 para indicação de partida bloqueada
2026-10-02 Corrige teste do estado normal do motor
